xehp/Power_for_Raspberry_PI/README.md

# Power_for_Raspberry_PI
An UPS and some extras for using a Raspberry PI as web interface GUI in an embedded system.

The UPS and HAT selected need to match

RPi_HAT_isolated_rs232 and SuperCapUps10_rs232 are matching.

Copyright (C) 2021
Henrik Björkman
www.eit.se/hb
