xehp/Power_for_Raspberry_PI/openscad/raspberry_DIN_rail_box.png

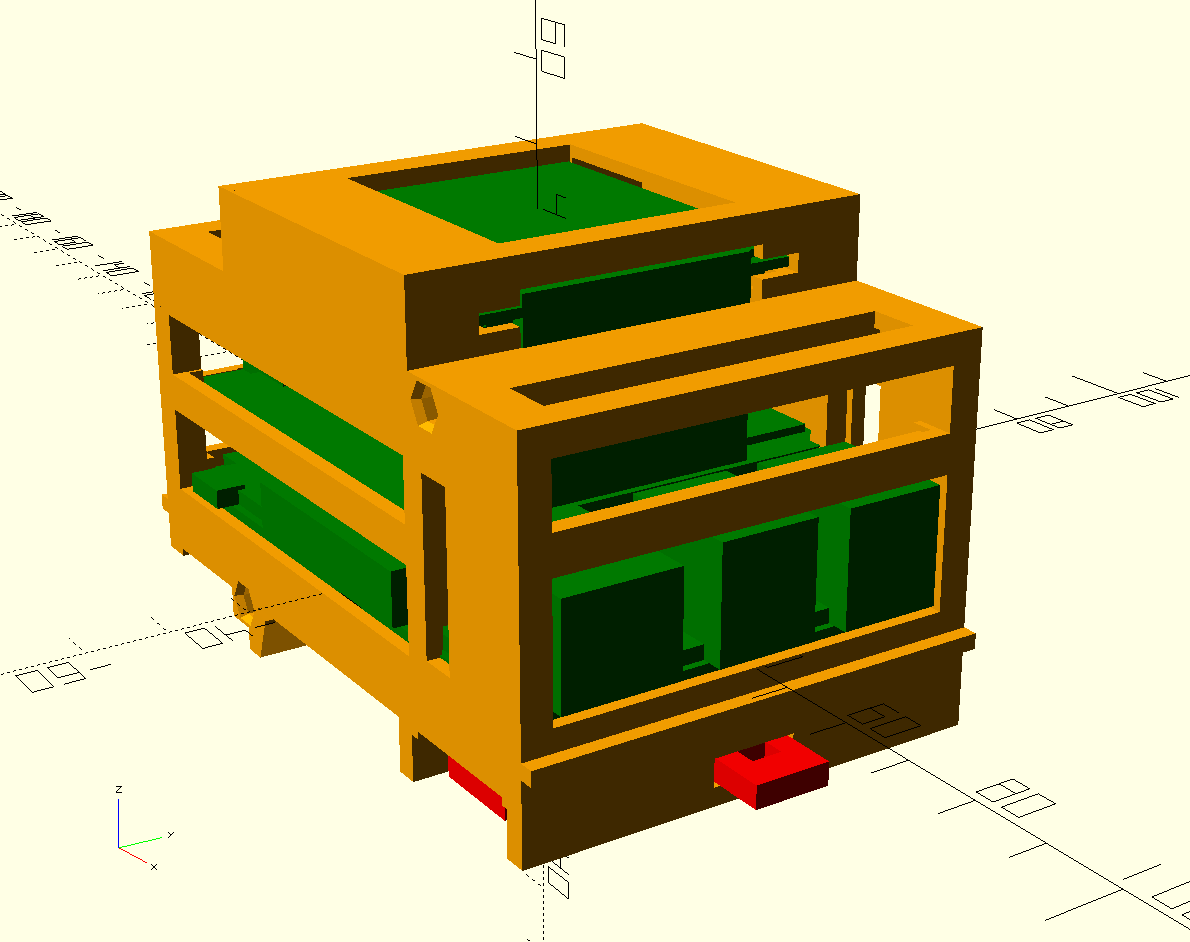
openscad/raspberry_DIN_rail_box.png
