xehp/Power_for_Raspberry_PI/habl/kicad/programmer_board/bom.txt

D41, D42
	Schottky Diode

	‎DIODE SCHOTTKY 60V 2A DO15 
	SMC Diode Solutions
	SB260TA‎
	digikey:1655-1520-1-ND‎

	For Diodes: Typically the katode (ring marked end) to the square pad. So Anode is the round pad.

D10
	Zener diode, 5.0 to 6.8 Volt.
	Littelfuse SA5.0A 	
	ESD Suppressors / TVS Diodes SA5.0A Uni-Directional
	mouser:576-SA5.0A 

	Littelfuse Inc.
	‎SA5.0A‎
	TVS DIODE 5V 9.2V DO204AC 
	digikey:SA5.0ALFCT-ND‎

D12, D20, D21, D53
	LED with builtin resistor for 5V

	Green:
	digikey:754-1891-ND

	Red:
	digikey:67-1068-ND
	
	Amber/Yellow:
	farnell:48472747

	Blue:
	Hmm, use some other color.

	For LEDs: Typically the katode (shorter leg) to square pad. So Anode (long leg) is the round pad.

D14
	Zener >=30 Volt
	TVS DIODE 33V 69.7V DO15
	STMicroelectronics (VA) / P6KE39A
	digikey:497-14733-1-ND

D60
	Diode
	digikey:1N4001-TPMSCT-ND

F70
	PTC RESET FUSE 90V 1.85A RADIAL
		digikey:507-1344-ND
	‎

J50
	micro USB
			GCT
			MICRO B SKT, BOTTOM-SMT, R/A, 30 
			‎USB3076-30-A‎
			footprint:Connector_USB:USB_Micro-B_GCT_USB3076-30-A
			digikey:2073-USB3076-30-ACT-ND‎

			Molex
			CONN RCPT USB2.0 MICRO B SMD R/A 
			‎1050170001
			footprint:Connector_USB:USB_Micro-B_Molex-105017-0001‎
			digikey:WM1399CT-ND‎

	Alternative designs:

		To be fully correct the ones above shall sit on the underside of PCB?
		This on upper side then?	
			Molex
			CONN RCPT USB2.0 MICRO B SMD R/A 
			‎1051640001‎
			digikey:WM11263CT-ND‎

	JLCPCB adapted
	
		Seems all these have same footprint (eit_footprints:USB_Micro_B_Female_jlcpcb) so any can be used.

		SHOU HAN, MicroXNJ
		footprint: USB_Micro_B_Female_jlcpcb.
		jlcpcb:C404969

		SHOU HAN, MICRO XNJ ZB
		footprint: USB_Micro_B_Female_jlcpcb.
		jlcpcb:C668587
		
		XKB Connectivity
		footprint: USB_Micro_B_Female_jlcpcb.
		jlcpcb:C319164

		Used this one (2021-06-15):

		Jing Extension of the Electronic Co.
		footprint: USB_Micro_B_Female_jlcpcb.
		jlcpcb:C10418

J60, J82
	Molex ‎0022292041‎
	CONN HEADER VERT 4POS 2.54MM 
	digikey:WM2746-ND‎

R40
	100 Ohm, >= 6 W

U10
	This one has an impressive input range:
	DC DC CONVERTER 3.3V 1.65W
	Linear Regulator Replacement DC DC Converter 1 Output 3.3V    500mA 4.75V - 36V Input
	digikey:102-4243-ND

	alternative designs:
		With 3.3 Volt Atmega can do 16MHz. But at that freq we can not get baudrate to be 115200. 
		20MHz perhaps we can but then we need 5 Volt VCC. Aha we will use 7.37 MHz.

		7805
		PMIC - spänningsregulatorer - linjära Positiv Fast 1 Utgång  1A TO-220AB
		digikey:MC7805CTGOS-ND

		heatsink
		V8508B
		digikey:A10746-ND

		Or 3.3 Volt is enough
		digikey:AP7381-33V-ADICT-ND

		Or use this one (pincompatible, will not need heatsink and gives impressive 3A):
		digikey:3182-LC78_05-3.0-ND

		DC DC CONVERTER 3.3V 2W
		digikey:945-1661-5-ND

U20
	‎ATMEGA328P-PU‎
	Microchip Technology
	IC MCU 8BIT 32KB FLASH 28DIP 
	digikey:ATMEGA328P-PU-ND‎

	Socket 28 pin DIL perhaps this:
		CONN IC DIP SOCKET 28POS GOLD 
		On Shore Technology Inc.
		‎SA283040‎
		digikey:ED3027-ND‎

	ZIF socket:
		Zero Insertion Force Socket
		28 (2 x 14) Positioner DIP, 0,3" (7,62mm) radavstånd Uttag
		digikey:1528-1926-ND

U50
	FT232RL-REEL	
	SSOP-28_5.3x10.2x0.65P
	jlcpcb:C8690

	alternatives (NOTE! not pin comatible)
	
		FTDI, Future Technology Devices International Ltd
		FT230XS-R
		IC USB SERIAL BASIC UART 16SSOP
		16-SSOP (0,154", 3,90mm bred) 
		digikey:768-1135-1-ND

		FTDI, FT230XS-R
		SSOP-16_3.9x4.9x0.635P
		jlcpcb:C69082

		FTDI, FT230XS-U
		SSOP-16_3.9x4.9x0.635P
		jlcpcb:C132162

	MORE alternatives (NOTE! not pin comatible)
		
		USB Brygga, USB till UART USB 2.0 UART Gränssnitt 16-QFN (4x4)
		digikey:768-1130-1-ND

		FT230
		Wanted "SOIC-16_W3.90mm" but are those available?

Y20
	Chrystal or resonator

	7,37MHz
		We do not need much CPU performance, this should work fine (this way we can get correct baudrate 115200):
		7,37MHz Keramisk Resonatorer Inbyggd kondensator 15pF ±0,2% 30 Ohms -20°C ~ 80°C Genomgående hål
		digikey:490-11079-ND

	16 MHz
		CERAMIC RES 16.0000MHZ 30PF T/H 
		Murata Electronics, ‎CSTLS16M0X55-B0‎
		digikey:490-1214-ND‎

		16 MHz will not give us 115200 baud.

FB50
	Inductor / Ferrite_bead
	SMD-4.2x4.4x2.0
	jlcpcb:C408335

PCB
	1) 
	Plot to gerber (at least these files):
	board-B_Cu.gbr
	board-B_Mask.gbr
	board-B_Paste.gbr
	board-B_SilkS.gbr
	board-Edge_Cuts.gbr
	board-F_Cu.gbr
	board-F_Mask.gbr
	board-F_Paste.gbr
	board-F_SilkS.gbr

	These two are not needed for 2 layer boards.
	board-In1_Cu.gbr
	board-In2_Cu.gbr

	These two perhaps not needed but I always sent them so might be required.
	board-NPTH.drl
	board-PTH.drl

	Make a zip of the above.
	
	2) 
	Go to schematic -> tools -> generate Bill Of Material "bom2grouped_csv_jlcpcb".

	3) 
	Back to layout -> fabrication outputs -> Footprint position (pos) file.
	Edit the first line in pos file. Replace as follows:
	Ref  -> Designator
	PosX -> Mid X
	PosY -> Mid Y
	Rot  -> Rotation
	Side -> Layer

	These 3 files can then be uploaded to jlcpcb.com for production.
