xehp/Power_for_Raspberry_PI/RPi_HAT_isolated_rs232/jlcpcb_2021-05-27/downloaded_bom.xls

Comment | Designator | Package | LCSC Part
10 uF | C21,C22,C23,C28 | Capacitor_SMD:C_1206_3216Metric | C13585
3.9K | R6,R8 | Resistor_SMD:R_0805_2012Metric_Pad1.15x1.40mm_HandSolder | C17614
D | D1 | Diode_SMD:D_SOD-123 | C8598
D | D21 | Diode_SMD:D_SMC | C35722
100 | R32 | Resistor_SMD:R_0805_2012Metric_Pad1.15x1.40mm_HandSolder | C17408
0.01 uF | C32 | Capacitor_SMD:C_0805_2012Metric_Pad1.15x1.40mm_HandSolder | C1710
0.1uF | C1,C2,C29,C31 | Capacitor_SMD:C_0805_2012Metric_Pad1.15x1.40mm_HandSolder | C49678
330 | R22,R26,R28 | Resistor_SMD:R_0805_2012Metric | C17630
10K | R29 | Resistor_SMD:R_0805_2012Metric | C17414
D_Zener | D26 | Diode_SMD:D_SMB | C78395
1k | R1,R31,R27 | Resistor_SMD:R_0805_2012Metric_Pad1.15x1.40mm_HandSolder | C17513
1K | R1,R31,R27 | Resistor_SMD:R_0805_2012Metric_Pad1.15x1.40mm_HandSolder | C17513
22 uF | C24,C25,C26,C27 | Capacitor_SMD:C_0805_2012Metric | C45783
100k | R25 | Resistor_SMD:R_0805_2012Metric_Pad1.15x1.40mm_HandSolder | C17407
