xehp/Power_for_Raspberry_PI/RPi_HAT_isolated_rs232/jlcpcb_2021-06-15/bom.xls

Comment | Designator | Package | LCSC Part
0805W8F2201T5E | R31,R39 | Resistor_SMD:R_0805_2012Metric_Pad1.15x1.40mm_HandSolder | C17520
CL31A106KBHNNNE | C21,C22,C23,C28,C70,C71 | Capacitor_SMD:C_1206_3216Metric | C13585
MAX232ESE+T | U60 | Package_SO:SOIC-16_3.9x9.9mm_P1.27mm | C26860
M24C02-WMN6TP | U2 | Housings_SOIC:SOIC-8_3.9x4.9mm_Pitch1.27mm | C7562
0805W8F2200T5E | R3 | Resistor_SMD:R_0805_2012Metric_Pad1.15x1.40mm_HandSolder | C17557
CL21B103KBANNNC | C32,C3,C20 | Capacitor_SMD:C_0805_2012Metric | C1710
CL21B103KBANNNC | C32,C3,C20 | Capacitor_SMD:C_0805_2012Metric | C1710
0805W8F3901T5E | R6,R8 | Resistor_SMD:R_0805_2012Metric_Pad1.15x1.40mm_HandSolder | C17614
CC0805KRX7R9BB104 | C29,C1,C2,C31,C60,C61,C62,C63,C64,C24 | Capacitor_SMD:C_0805_2012Metric | C49678
0805W8F3300T5E | R1 | Resistor_SMD:R_0805_2012Metric_Pad1.15x1.40mm_HandSolder | C17630
0805W8F1002T5E | R29 | Resistor_SMD:R_0805_2012Metric | C17414
1206W4F2200T5E | R20 | Resistor_SMD:R_1206_3216Metric | C17957
P6SMB6.8CA | D26 | Diode_SMD:D_SMB | C78395
CL31A476MPHNNNE | C25,C26,C27 | Capacitor_SMD:C_1206_3216Metric | C96123
SS54 | D21 | Diode_SMD:D_SMA | C22452
0805W8F3301T5E | R2 | Resistor_SMD:R_0805_2012Metric_Pad1.15x1.40mm_HandSolder | C26010
0805W8F1001T5E | R27,R28 | Resistor_SMD:R_0805_2012Metric | C17513
0805W8F1500T5E | R26,R32,R38 | Resistor_SMD:R_0805_2012Metric | C17471
MMBT5401 | Q1,Q39 | Package_TO_SOT_SMD:SOT-23 | C8326
NCD0805R1 | D1,D24,D39 | LED_SMD:LED_0805_2012Metric | C84256
