xehp/Power_for_Raspberry_PI/RPi_HAT_isolated_rs232/jlcpcb_2021-05-27/schematics_2021-05-27.pdf

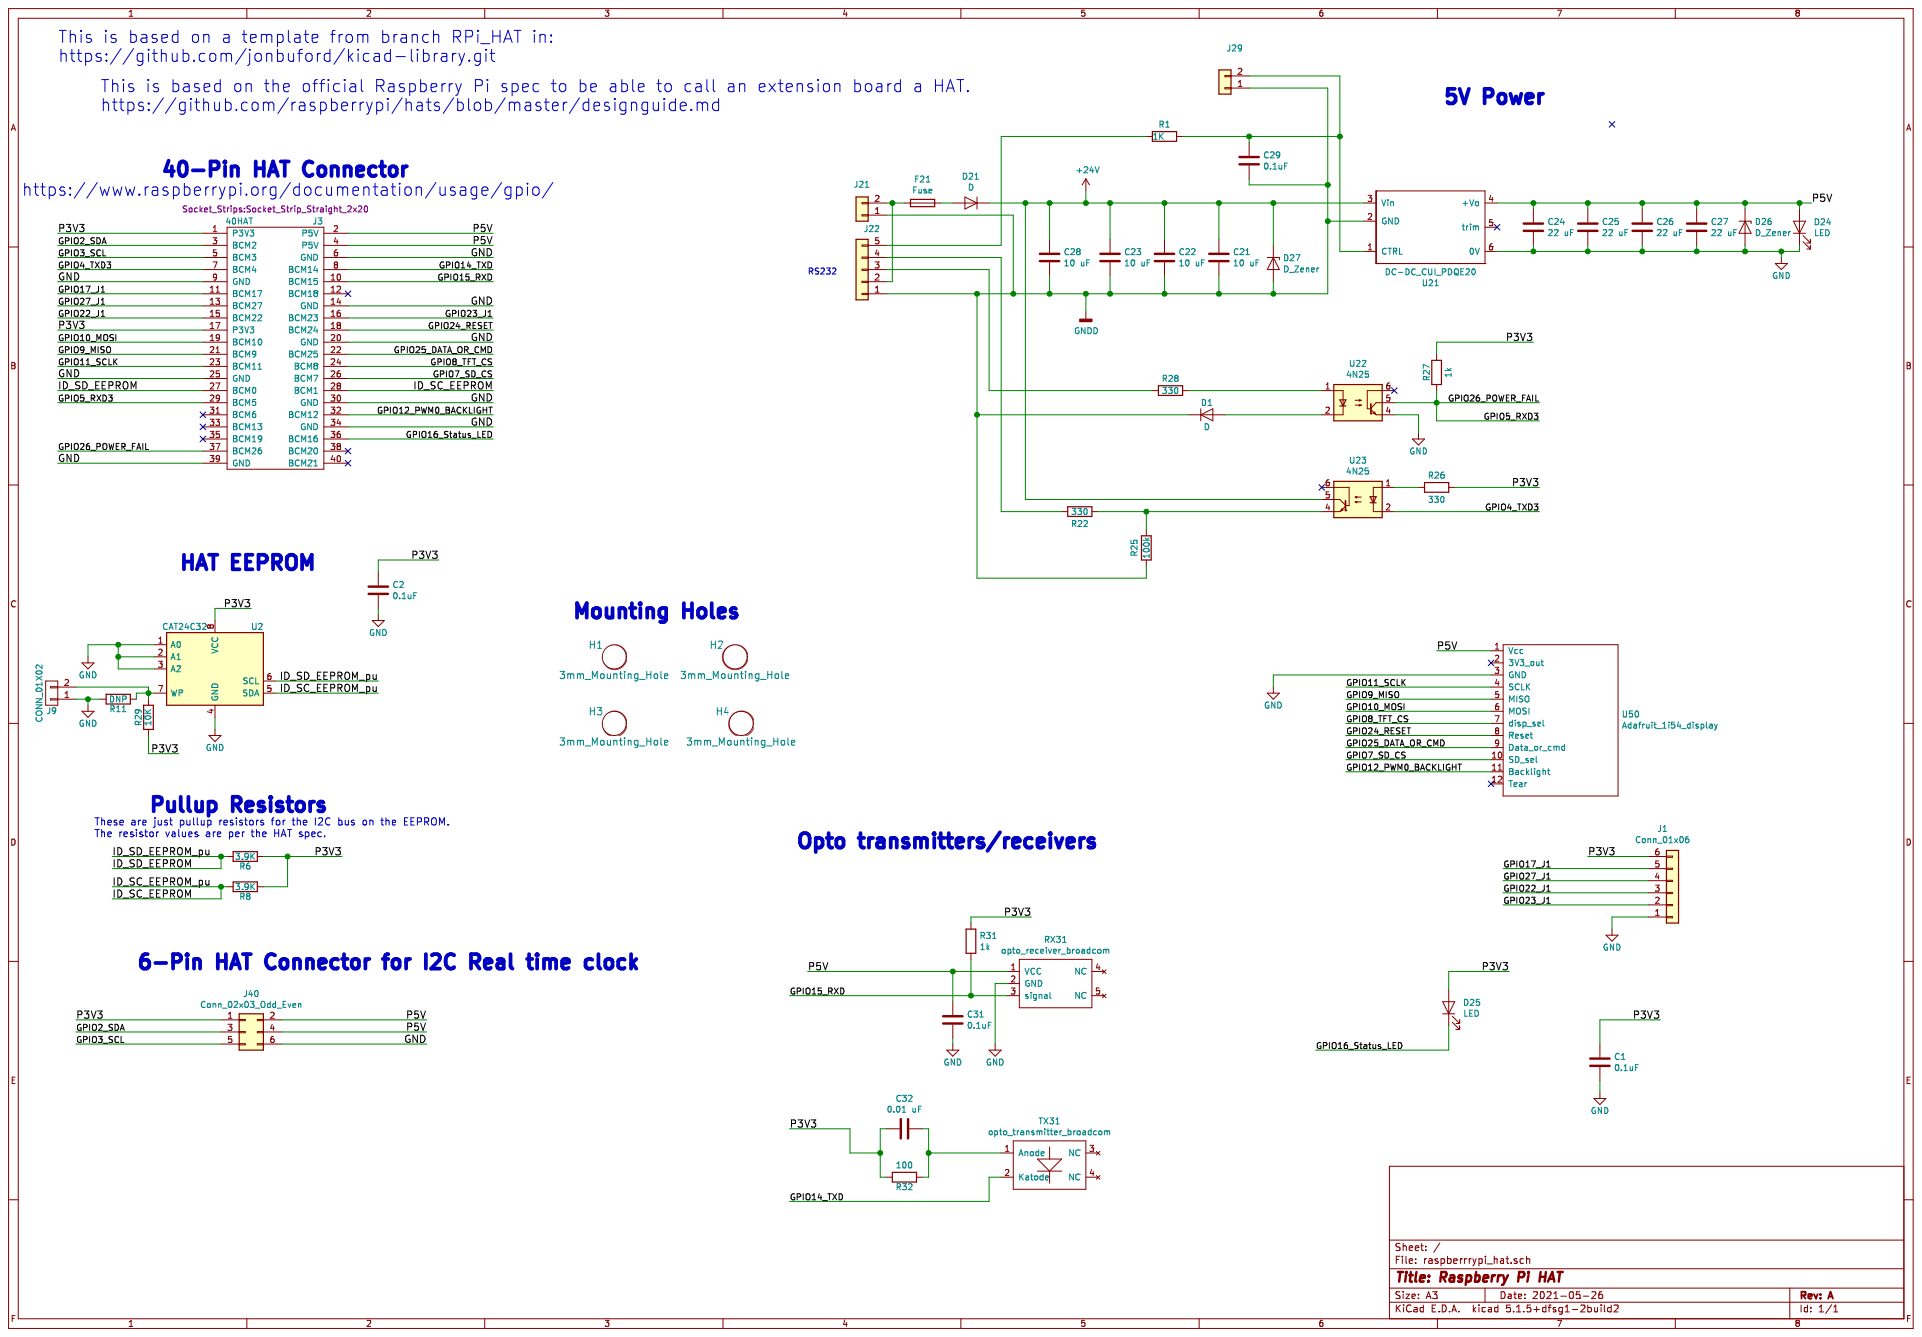
[picture p2: page 1]
