xehp/Power_for_Raspberry_PI/RPi_HAT_isolated_rs232/jlcpcb_2021-06-15/schematics.pdf

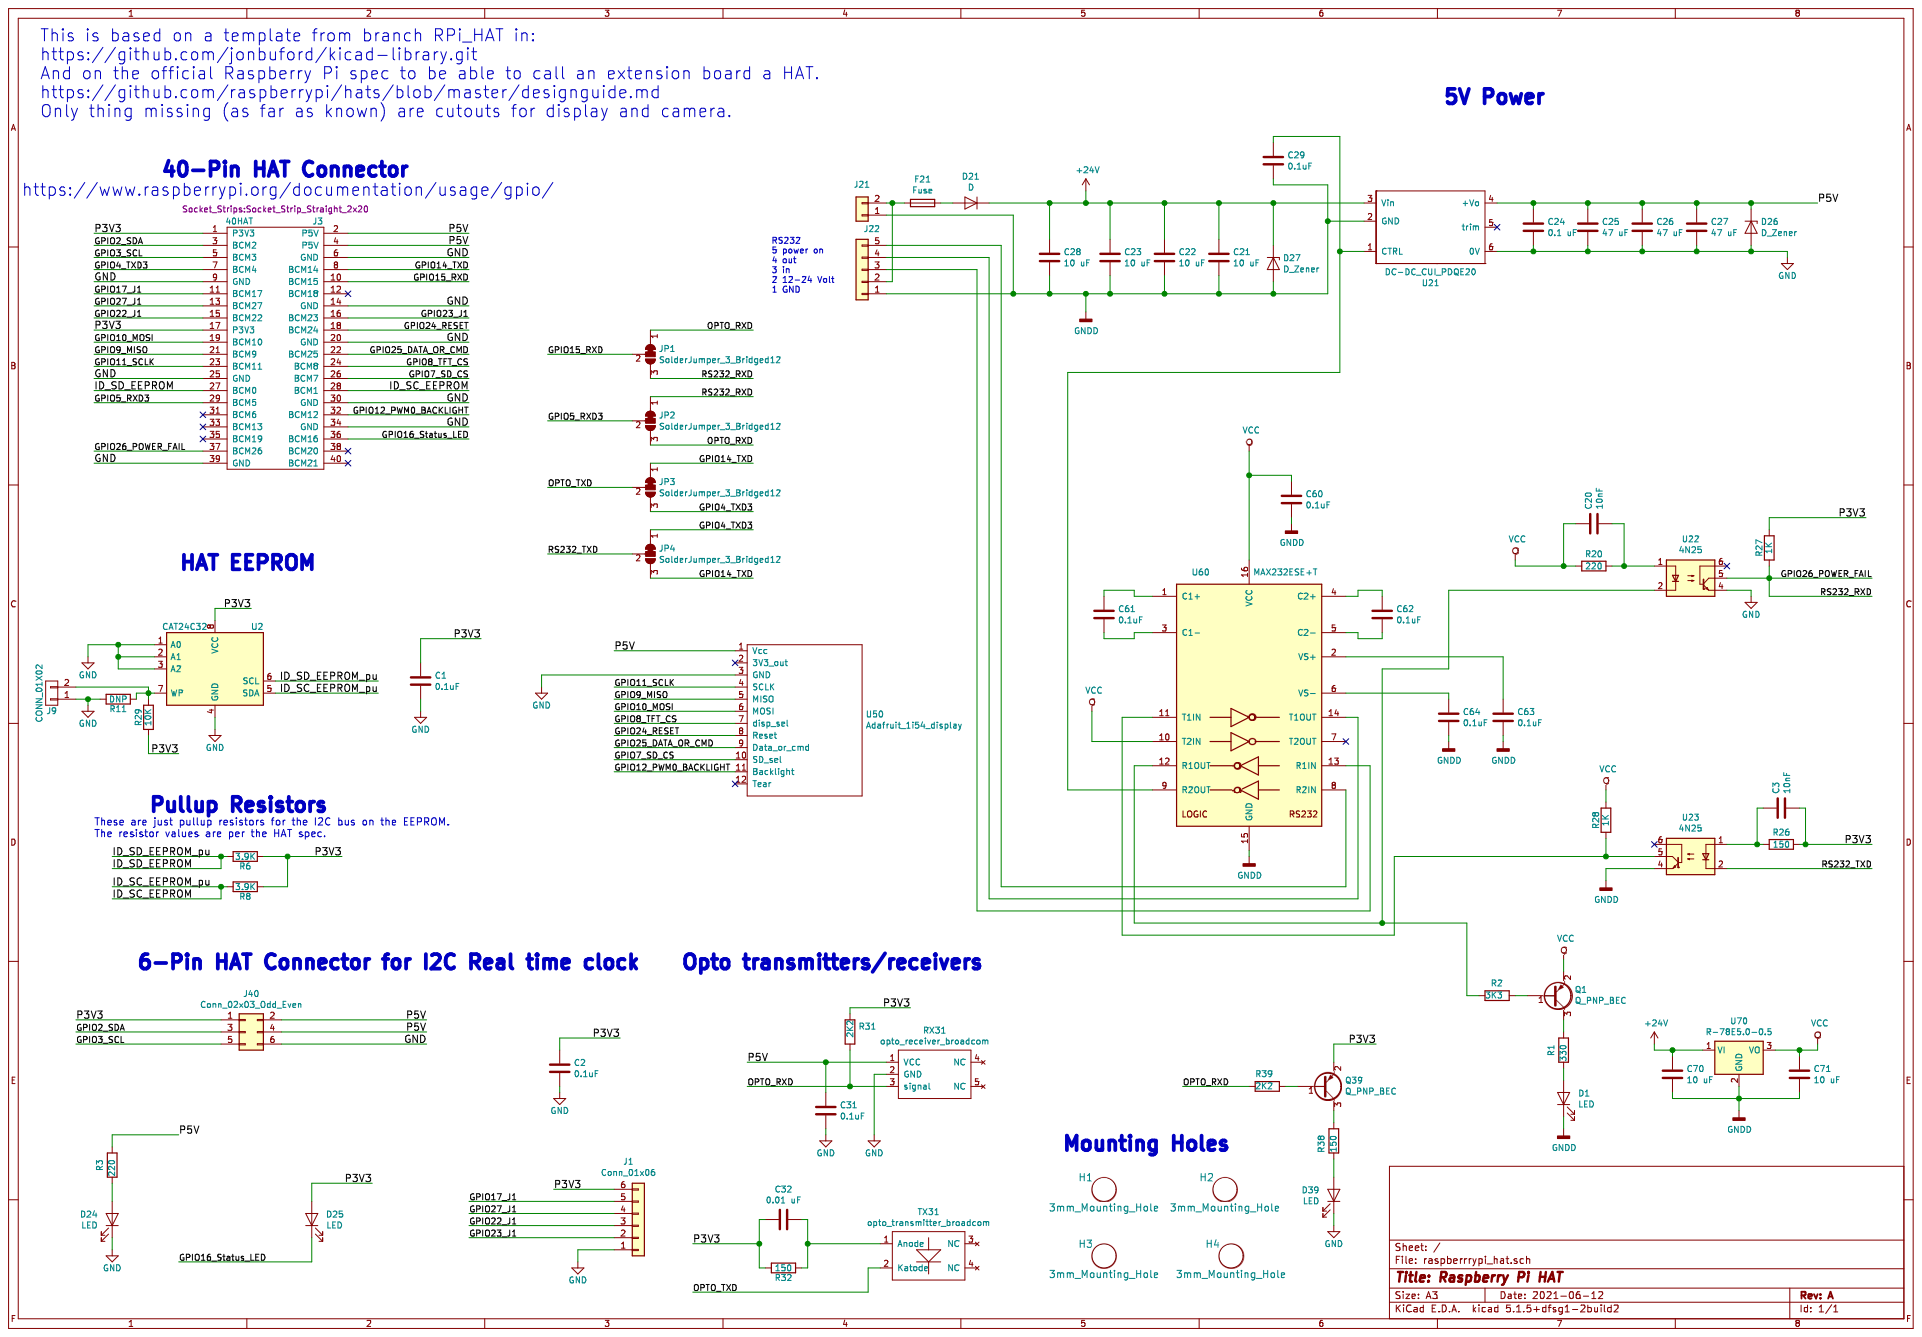
[picture p3: page 1]
