xehp/Power_for_Raspberry_PI/SuperCapUps7_rs232/jlcpcb_2021-06-14/schematics.pdf

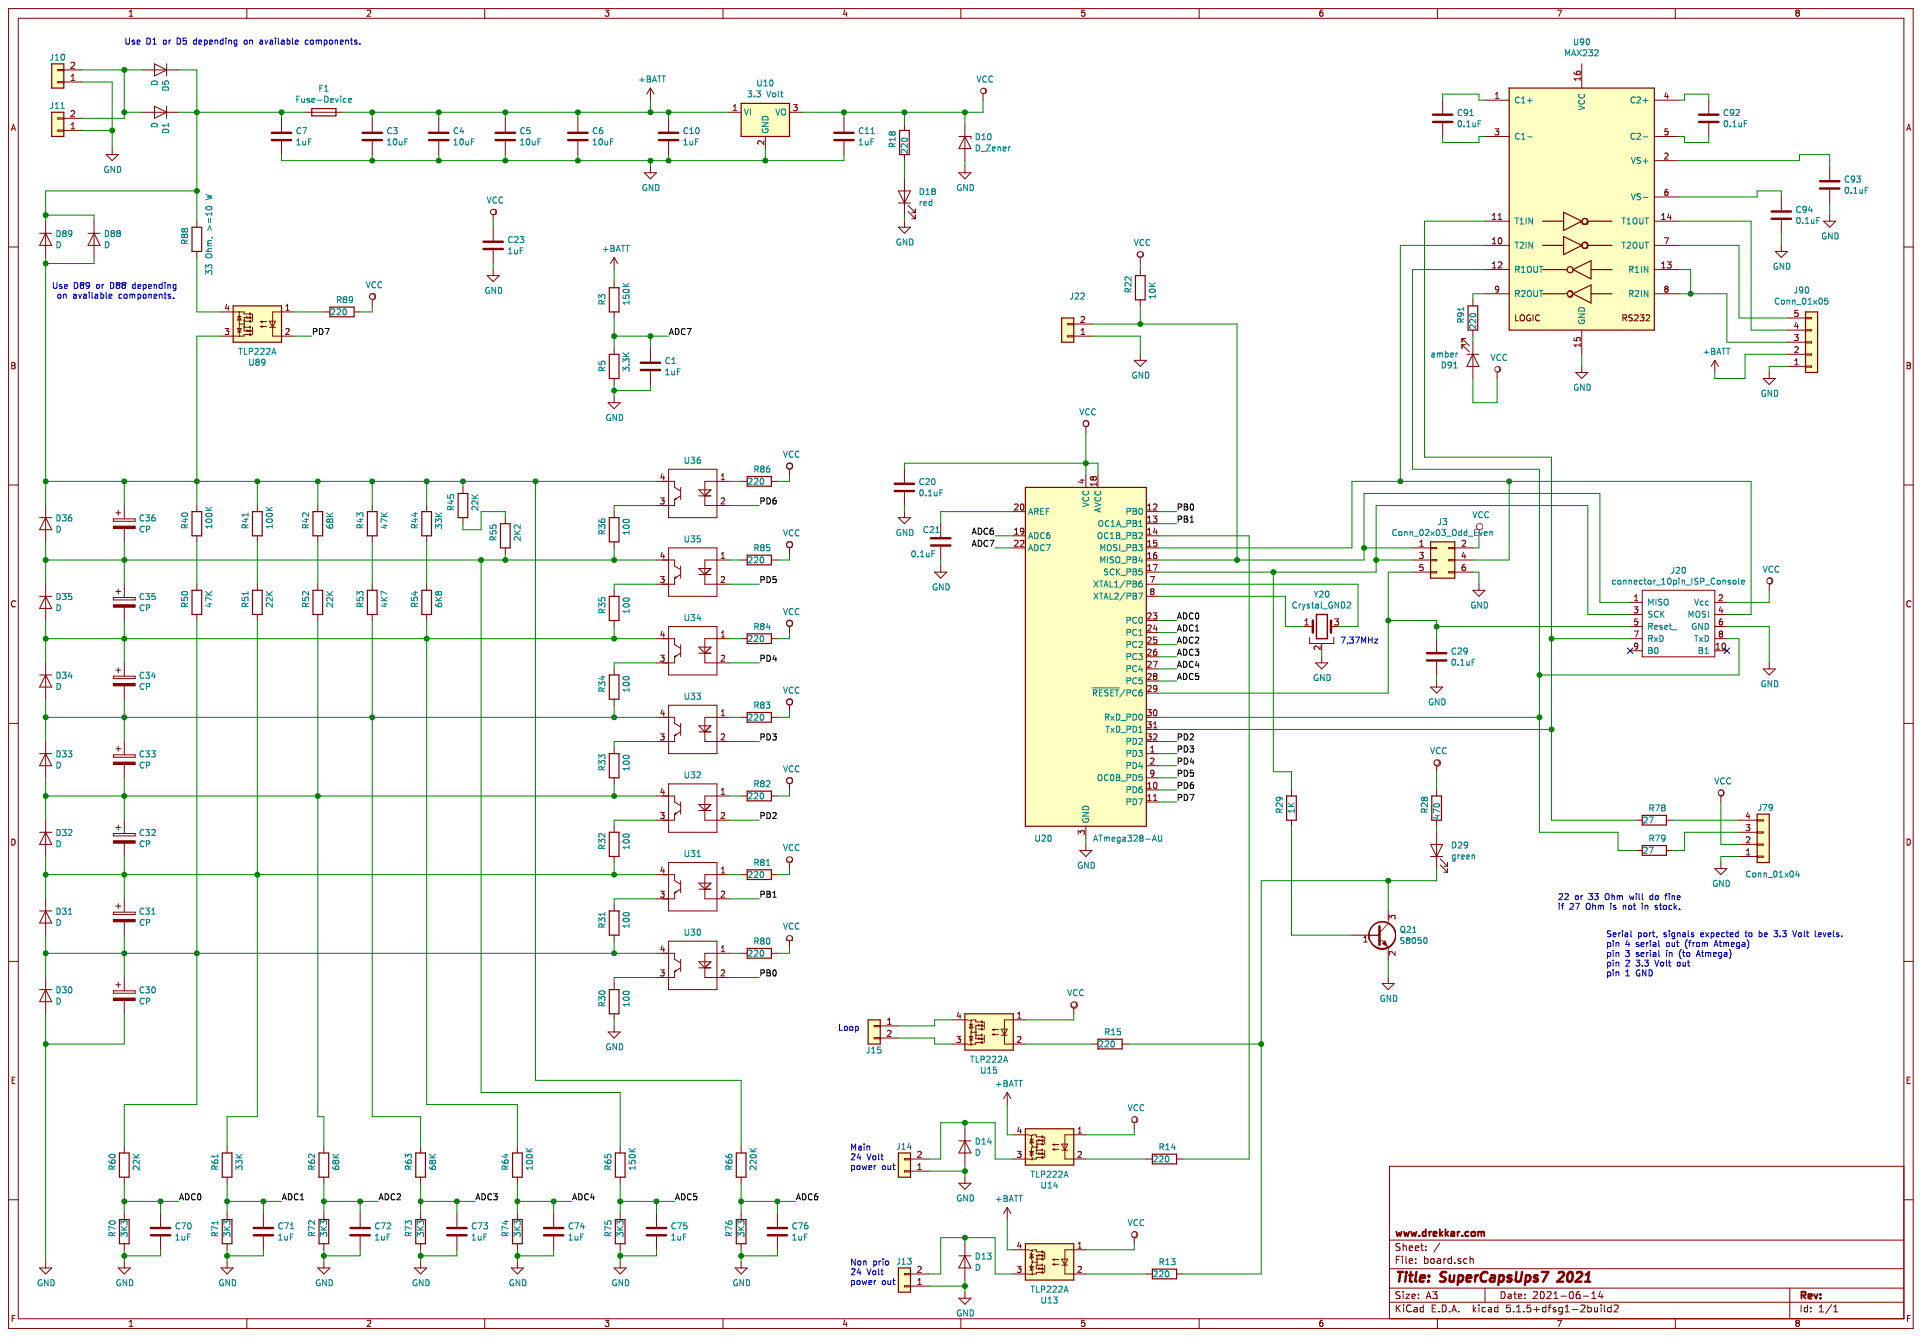
[picture p4: page 1]
