xehp/Power_for_Raspberry_PI/RPi_HAT_isolated_rs232/raspberrrypi_hat.kicad_pcb

## KiCad design RPi_HAT_isolated_rs232/raspberrrypi_hat.kicad_pcb (2021-10-06)

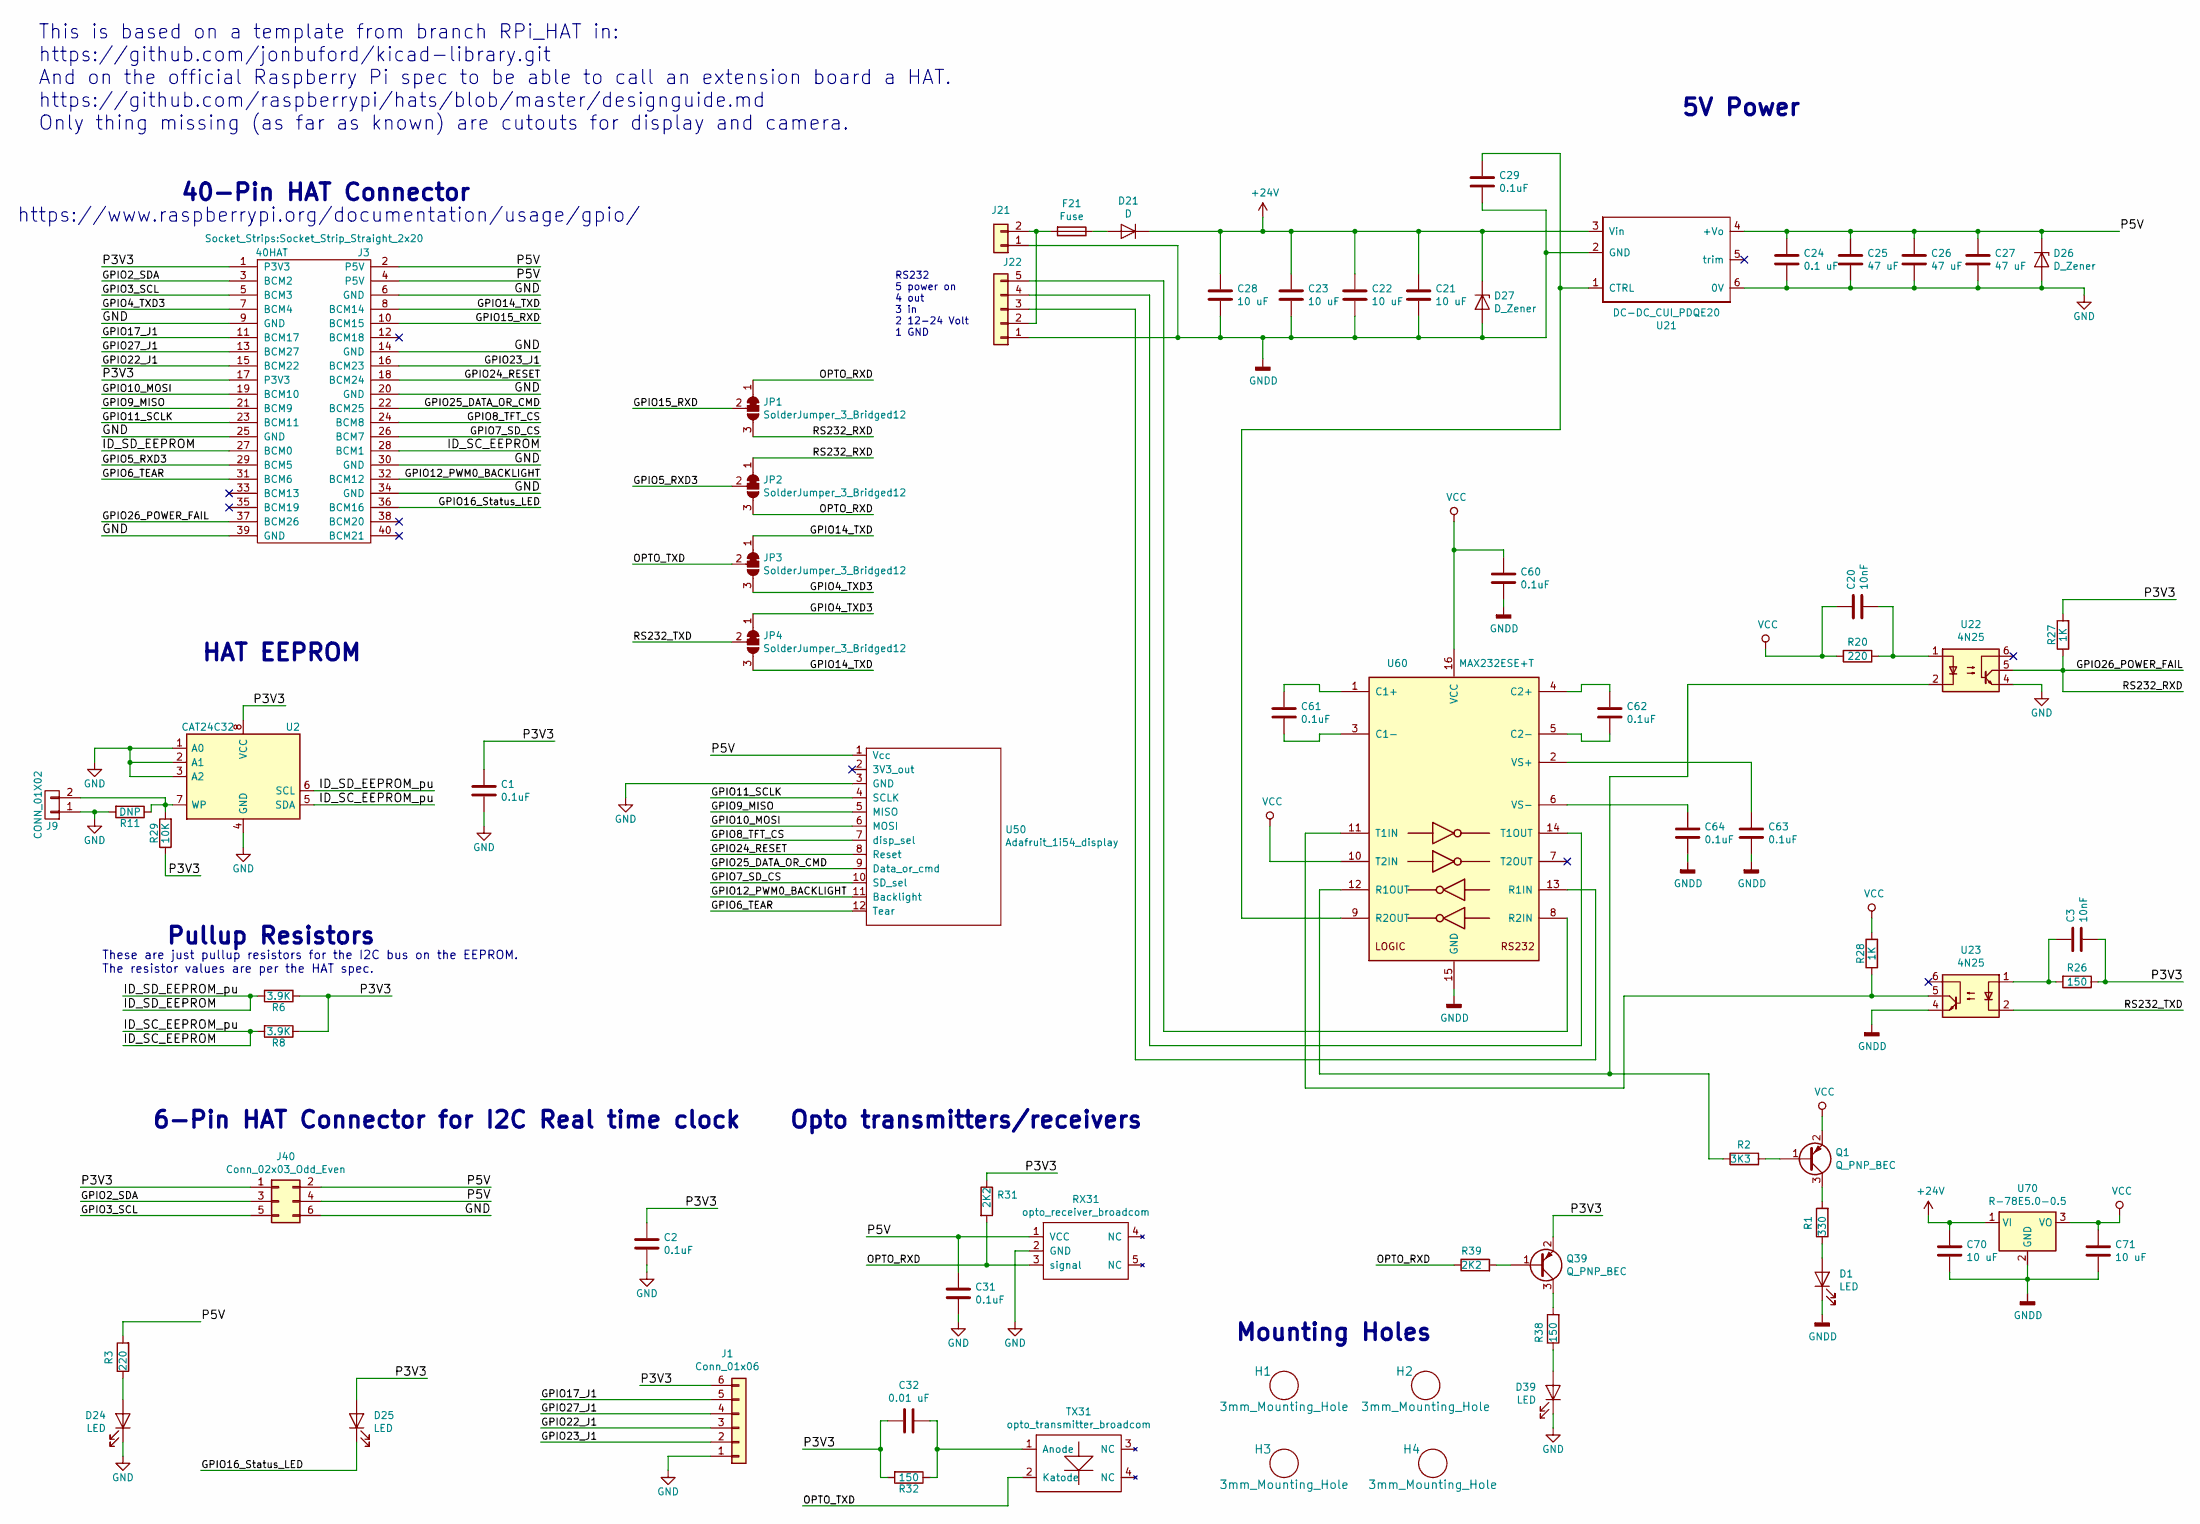
[picture p5: schematic raspberrrypi_hat.sch, Raspberry Pi HAT]

Parts:
C1, C2, C31, C60, C61, C62, C63, C64: 0.1uF; C_0805_2012Metric
C3, C20: 10nF; C_0805_2012Metric
C21, C22, C23, C28, C70, C71: 10 uF; C_1206_3216Metric
C24: 0.1 uF; C_0805_2012Metric
C25, C26, C27: 47 uF; C_1206_3216Metric
C29: 0.1uF; C_0805_2012Metric_Pad1.15x1.40mm_HandSolder
C32: 0.01 uF; C_0805_2012Metric
D1, D24, D39: LED; LED_0805_2012Metric
D21: D; D_SMA
D25: LED; LED_D3.0mm
D26: D_Zener; D_SMB
D27: D_Zener; D_A-405_P2.54mm_Vertical_AnodeUp
F21: Fuse; R_Radial_Power_L11.0mm_W7.0mm_P5.00mm
H1, H2, H3, H4: 3mm_Mounting_Hole; NPTH_3mm_ID
J1: Conn_01x06; Molex_KK-254_AE-6410-06A_1x06_P2.54mm_Vertical
J3: 40HAT; Socket_Strip_Straight_2x20
J9: CONN_01X02; PinHeader_1x02_P2.54mm_Vertical
J21: Conn_01x02; connector_TE_Connectivity_2_pin
J22: Conn_01x05; Molex_KK-254_AE-6410-05A_1x05_P2.54mm_Vertical
J40: Conn_02x03_Odd_Even; PinHeader_2x03_P2.54mm_Vertical
JP1, JP2, JP3, JP4: SolderJumper_3_Bridged12; SolderJumper-3_P2.0mm_Open_TrianglePad1.0x1.5mm_NumberLabels
Q1, Q39: Q_PNP_BEC; SOT-23
R1: 330; R_0805_2012Metric_Pad1.15x1.40mm_HandSolder
R2: 3K3; R_0805_2012Metric_Pad1.15x1.40mm_HandSolder
R3: 220; R_0805_2012Metric_Pad1.15x1.40mm_HandSolder
R6, R8: 3.9K; R_0805_2012Metric_Pad1.15x1.40mm_HandSolder; MPN RC0402JR-0722RL
R11: DNP; R_0805_HandSoldering; MPN RC0402JR-0722RL
R20: 220; R_1206_3216Metric; MPN RC0402JR-0722RL
R26: 150; R_0805_2012Metric; MPN RC0402JR-0722RL
R27, R28: 1K; R_0805_2012Metric; MPN RC0402JR-0722RL
R29: 10K; R_0805_2012Metric; MPN RC0402JR-0722RL
R31, R39: 2K2; R_0805_2012Metric_Pad1.15x1.40mm_HandSolder
R32: 150; R_0805_2012Metric_Pad1.15x1.40mm_HandSolder; MPN RC0402JR-0722RL
R38: 150; R_0805_2012Metric_Pad1.15x1.40mm_HandSolder
RX31: opto_receiver_broadcom; opto_receiver_broadwell
TX31: opto_transmitter_broadcom; opto_transmitter_broadwell
U2: CAT24C32; SOIC-8_3.9x4.9mm_Pitch1.27mm
U21: DC-DC_CUI_PDQE20; DC-DC_CUI_PDQE20-D
U22, U23: 4N25; DIP-6_W7.62mm
U50: Adafruit_1i54_display
U60: MAX232ESE+T; SOIC-16_3.9x9.9mm_P1.27mm
U70: R-78E5.0-0.5; DC-DC-Recom-R78

Connections:
+24V: C21.1, C22.1, C23.1, C28.1, C70.1, D21.1 (K), D27.1 (K), U21.3 (Vin), U70.1 (VI)
/GPIO2_SDA: J3.3 (BCM2), J40.3
/GPIO3_SCL: J3.5 (BCM3), J40.5
/GPIO4_TXD3: J3.7 (BCM4), JP3.3 (B), JP4.1 (A)
/GPIO5_RXD3: J3.29 (BCM5), JP2.2 (C)
/GPIO7_SD_CS: J3.26 (BCM7), U50.10 (SD_sel)
/GPIO8_TFT_CS: J3.24 (BCM8), U50.7 (disp_sel)
/GPIO9_MISO: J3.21 (BCM9), U50.5 (MISO)
/GPIO10_MOSI: J3.19 (BCM10), U50.6 (MOSI)
/GPIO11_SCLK: J3.23 (BCM11), U50.4 (SCLK)
/GPIO12_PWM0_BACKLIGHT: J3.32 (BCM12), U50.11 (Backlight)
/GPIO14_TXD: J3.8 (BCM14), JP3.1 (A), JP4.3 (B)
/GPIO15_RXD: J3.10 (BCM15), JP1.2 (C)
/GPIO16_Status_LED: D25.1 (K), J3.36 (BCM16)
/GPIO17_J1: J1.5, J3.11 (BCM17)
/GPIO22_J1: J1.3, J3.15 (BCM22)
/GPIO23_J1: J1.2, J3.16 (BCM23)
/GPIO24_RESET: J3.18 (BCM24), U50.8 (Reset)
/GPIO25_DATA_OR_CMD: J3.22 (BCM25), U50.9 (Data_or_cmd)
/GPIO26_POWER_FAIL: J3.37 (BCM26), JP1.3 (B), JP2.1 (A), R27.1, U22.5
/GPIO27_J1: J1.4, J3.13 (BCM27)
/ID_SC_EEPROM: J3.28 (BCM1), R8.2, U2.5 (SDA)
/ID_SD_EEPROM: J3.27 (BCM0), R6.2, U2.6 (SCL)
/OPTO_RXD: JP1.1 (A), JP2.3 (B), R31.2, R39.1, RX31.3 (signal)
/OPTO_TXD: JP3.2 (C), TX31.2 (Katode)
/P3V3: C1.1, C2.1, C3.2, C32.2, D25.2 (A), J1.6, J3.1 (P3V3), J3.17 (P3V3), J40.1, Q39.2 (E), R6.1, R8.1, R26.1, R27.2, R29.1, R31.1, R32.2, U2.8 (VCC)
/P5V: C24.1, C25.1, C26.1, C27.1, C31.1, D26.1 (K), J3.2 (P5V), J3.4 (P5V), J40.2, J40.4, R3.2, RX31.1 (VCC), U21.4 (+Vo), U50.1 (Vcc)
/RS232_TXD: JP4.2 (C), U23.2
GND: C1.2, C2.2, C24.2, C25.2, C26.2, C27.2, C31.2, D24.1 (K), D26.2 (A), D39.1 (K), J1.1, J3.6 (GND), J3.9 (GND), J3.14 (GND), J3.20 (GND), J3.25 (GND), J3.30 (GND), J3.34 (GND), J3.39 (GND), J9.1, J40.6, R11.2, RX31.2 (GND), U2.1 (A0), U2.2 (A1), U2.3 (A2), U2.4 (GND), U21.6 (0V), U22.4, U50.3 (GND)
GNDD: C21.2, C22.2, C23.2, C28.2, C29.2, C60.2, C63.2, C64.2, C70.2, C71.2, D1.1 (K), D27.2 (A), J21.1, J22.1, U21.2 (GND), U23.4, U60.15 (GND), U70.2 (GND)
unnamed: C3.1, R26.2, U23.1
unnamed: C20.2, R20.1, U22.1
unnamed: C29.1, U21.1 (CTRL), U60.9 (R2OUT)
unnamed: C32.1, R32.1, TX31.1 (Anode)
unnamed: C61.1, U60.1 (C1+)
unnamed: C61.2, U60.3 (C1-)
unnamed: C62.1, U60.4 (C2+)
unnamed: C62.2, U60.5 (C2-)
unnamed: C63.1, U60.2 (VS+)
unnamed: C64.1, U60.6 (VS-)
unnamed: D1.2 (A), R1.1
unnamed: D21.2 (A), F21.1
unnamed: D24.2 (A), R3.1
unnamed: D39.2 (A), R38.1
unnamed: F21.2, J21.2, J22.2
unnamed: J9.2, R11.1, R29.2, U2.7 (WP)
unnamed: J22.3, U60.13 (R1IN)
unnamed: J22.4, U60.14 (T1OUT)
unnamed: J22.5, U60.8 (R2IN)
unnamed: Q1.1 (B), R2.2
unnamed: Q1.3 (C), R1.2
unnamed: Q39.1 (B), R39.2
unnamed: Q39.3 (C), R38.2
unnamed: R2.1, U22.2, U60.12 (R1OUT)
unnamed: R28.1, U23.5, U60.11 (T1IN)
VCC: C20.1, C60.1, C71.1, Q1.2 (E), R20.2, R28.2, U60.10 (T2IN), U60.16 (VCC), U70.3 (VO)

Notes on the sheet:
Pullup Resistors
HAT EEPROM
Mounting Holes
40-Pin HAT Connector
These are just pullup resistors for the I2C bus on the EEPROM. The resistor values are per the HAT spec.
This is based on a template from branch RPi_HAT in: https://github.com/jonbuford/kicad-library.git And on the official Raspberry Pi spec to be able to call an extension board a HAT. https://github.com/raspberrypi/hats/blob/master/designguide.md Only thing missing (as far as known) are cutouts for d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
Opto transmitters/receivers
6-Pin HAT Connector for I2C Real time clock
https://www.raspberrypi.org/documentation/usage/gpio/
5V Power
RS232 5 power on 4 out 3 in 2 12-24 Volt 1 GND

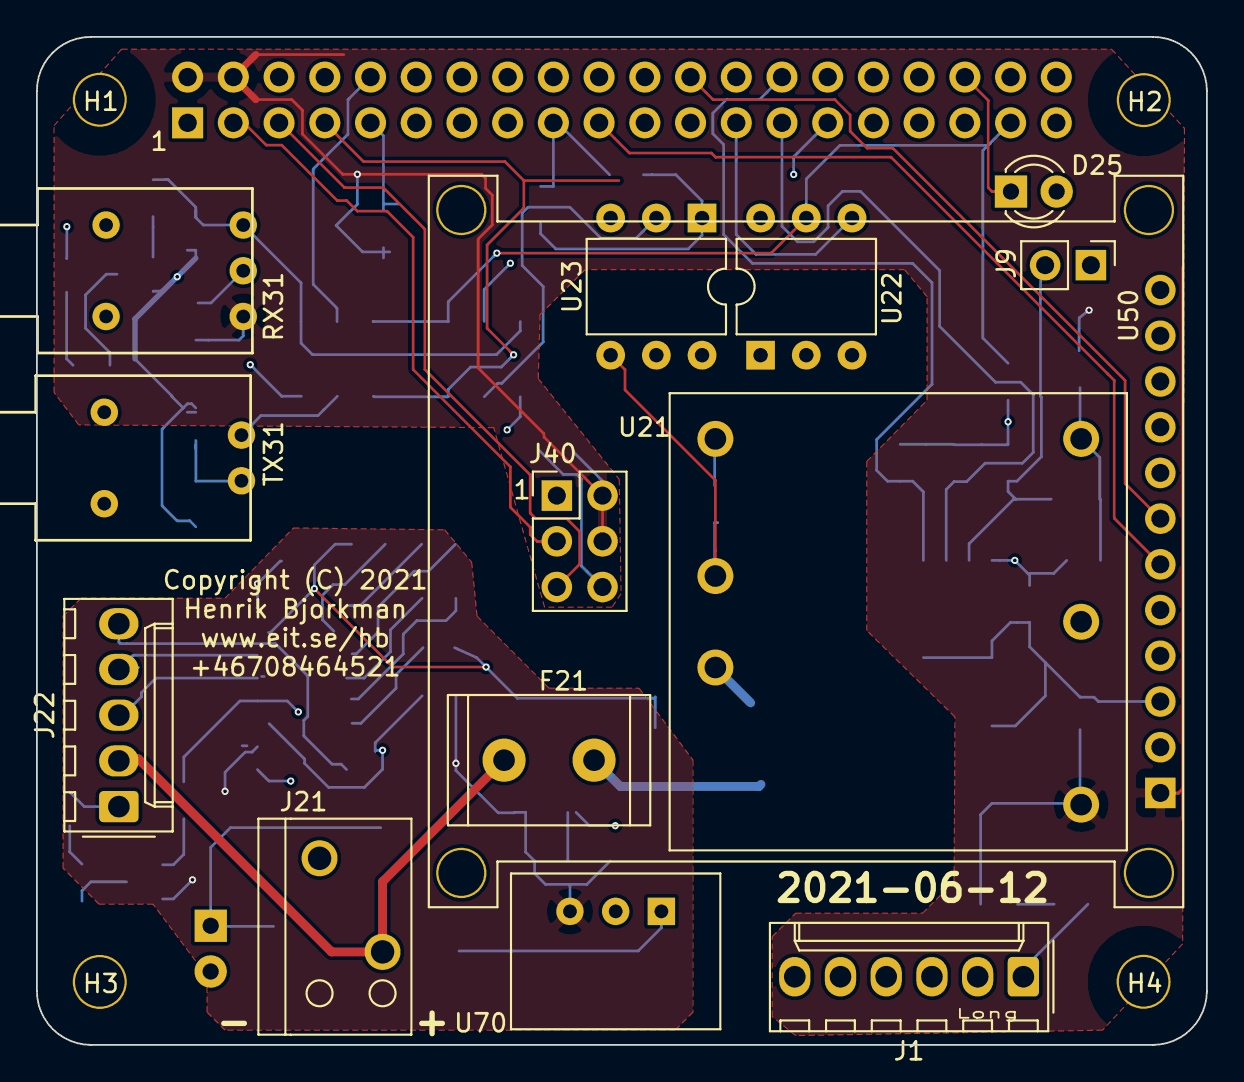
[picture p6: board raspberrrypi_hat.kicad_pcb from above]

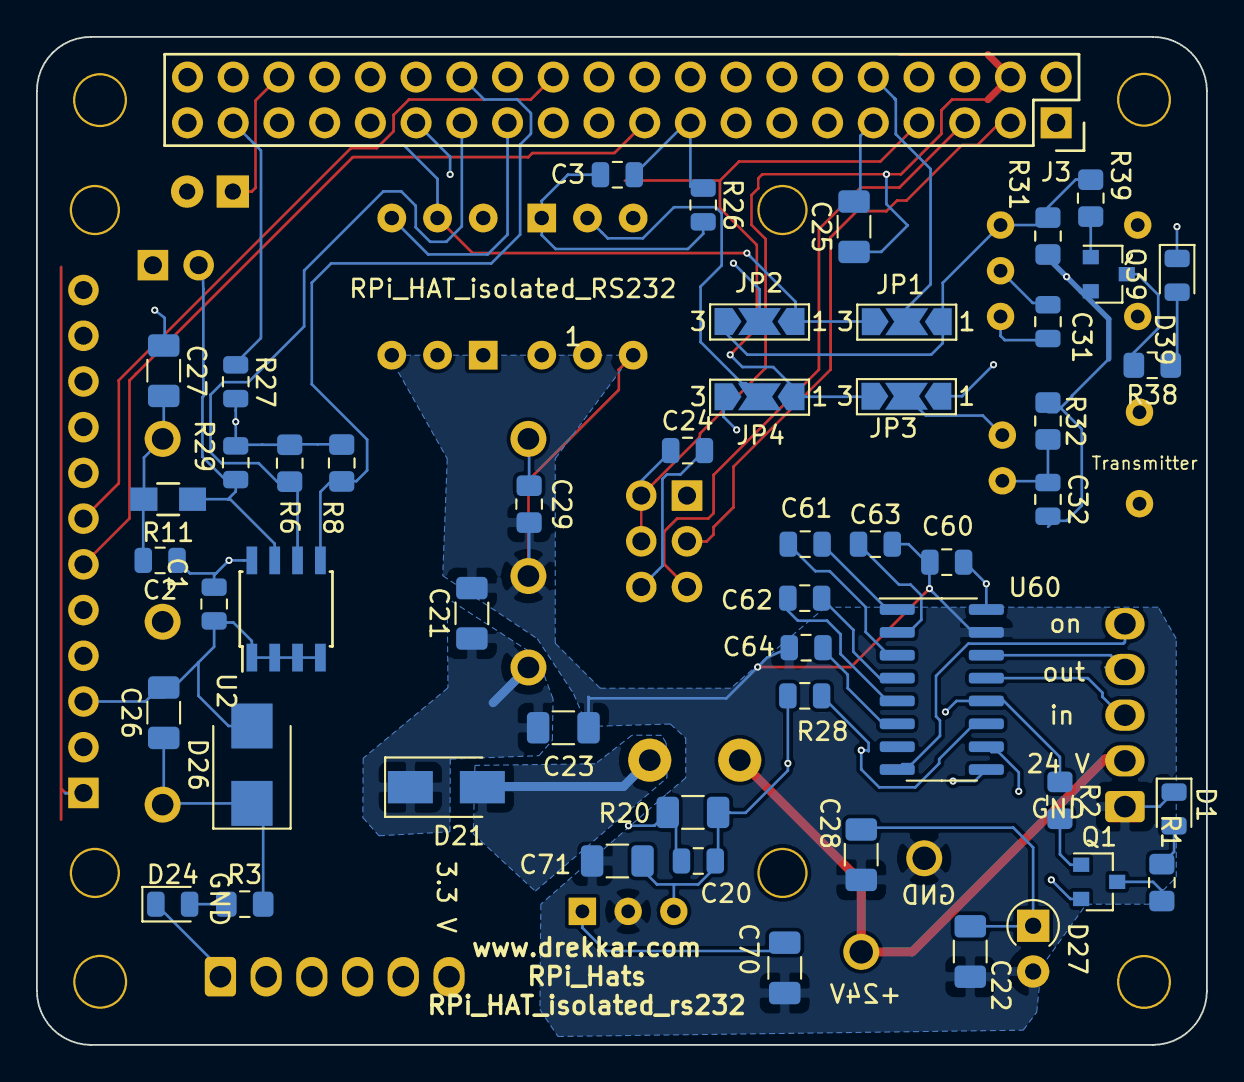
[picture p7: board raspberrrypi_hat.kicad_pcb from below]

Board: 4 copper layers, 65.0 x 56.0 mm, 70 parts (52 on the bottom side), 56 nets.
