xehp/Power_for_Raspberry_PI/SuperCapUps7_rs232/board.kicad_pcb

## KiCad design SuperCapUps7_rs232/board.kicad_pcb (2021-09-27)

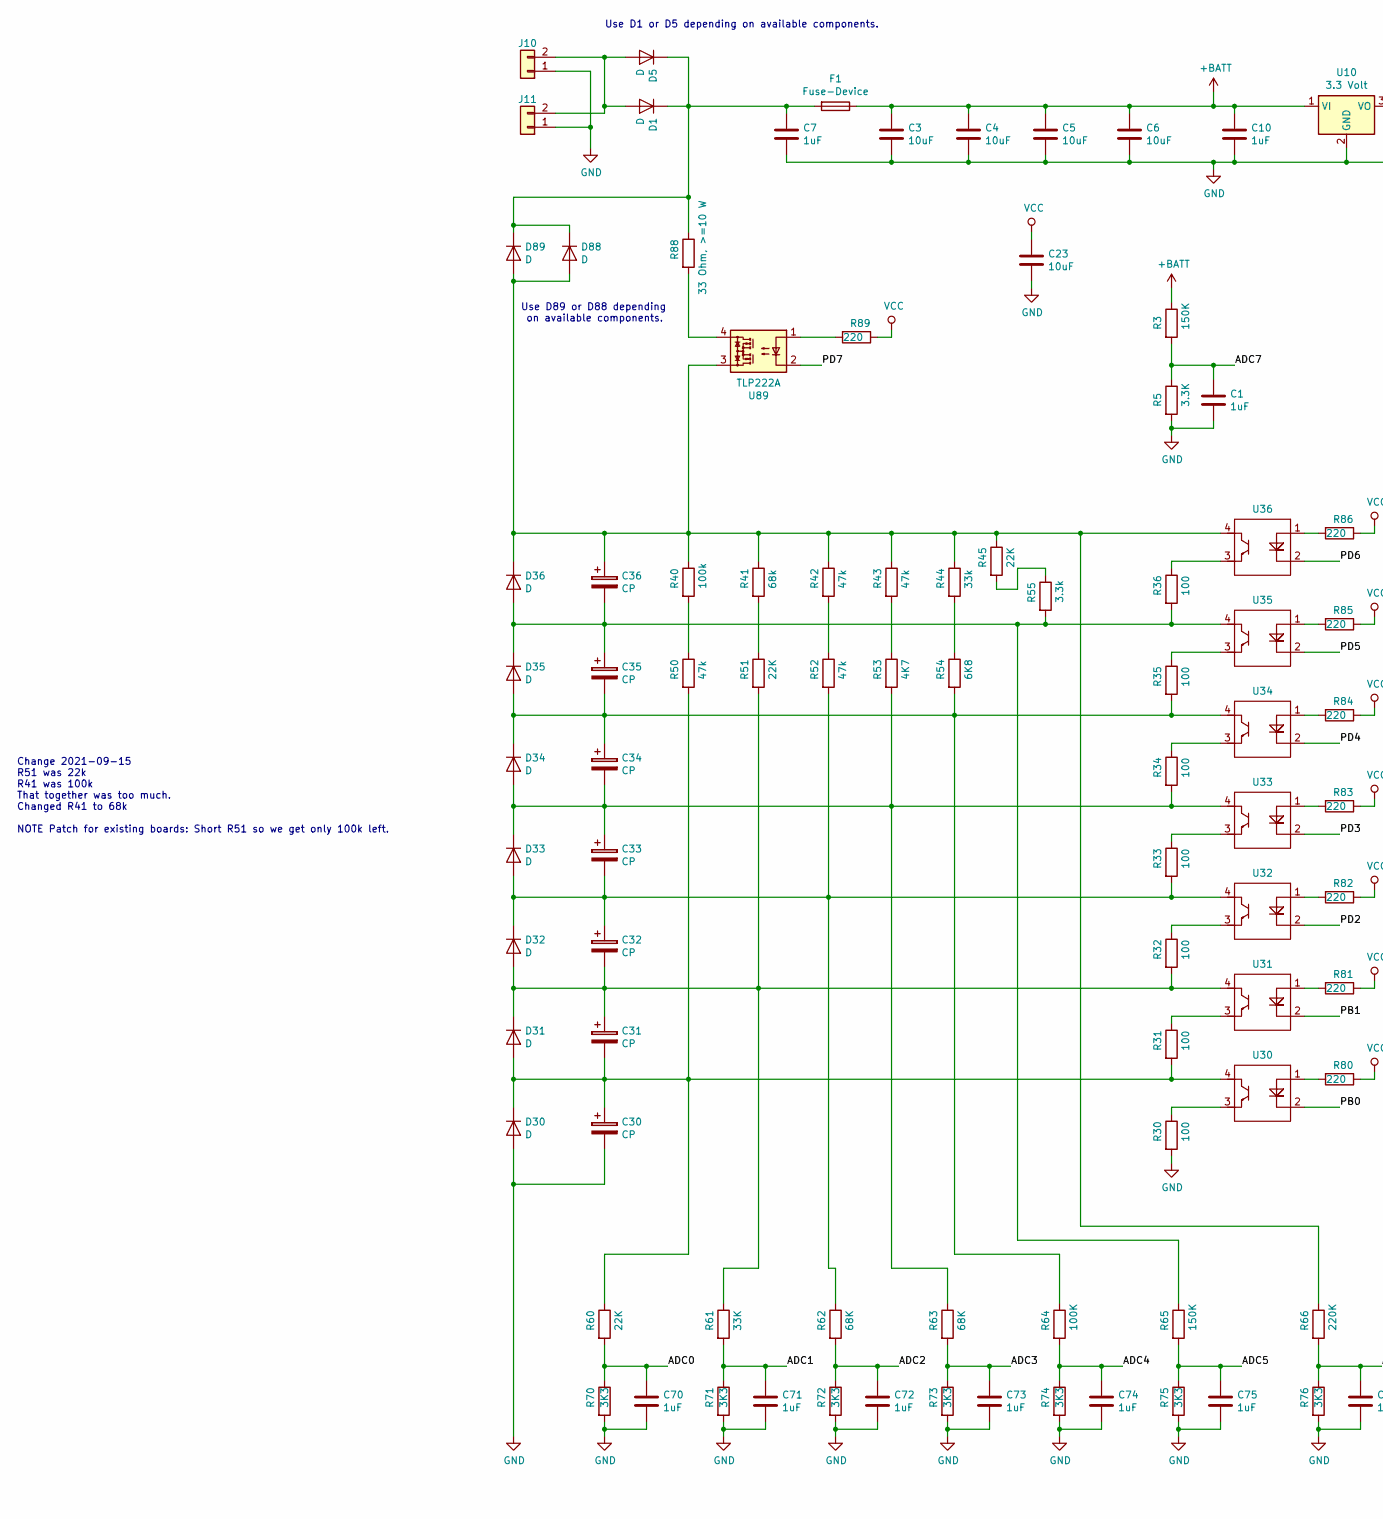
[picture p8: schematic board.sch, SuperCapsUps7 2021, part in row 1, column 1]

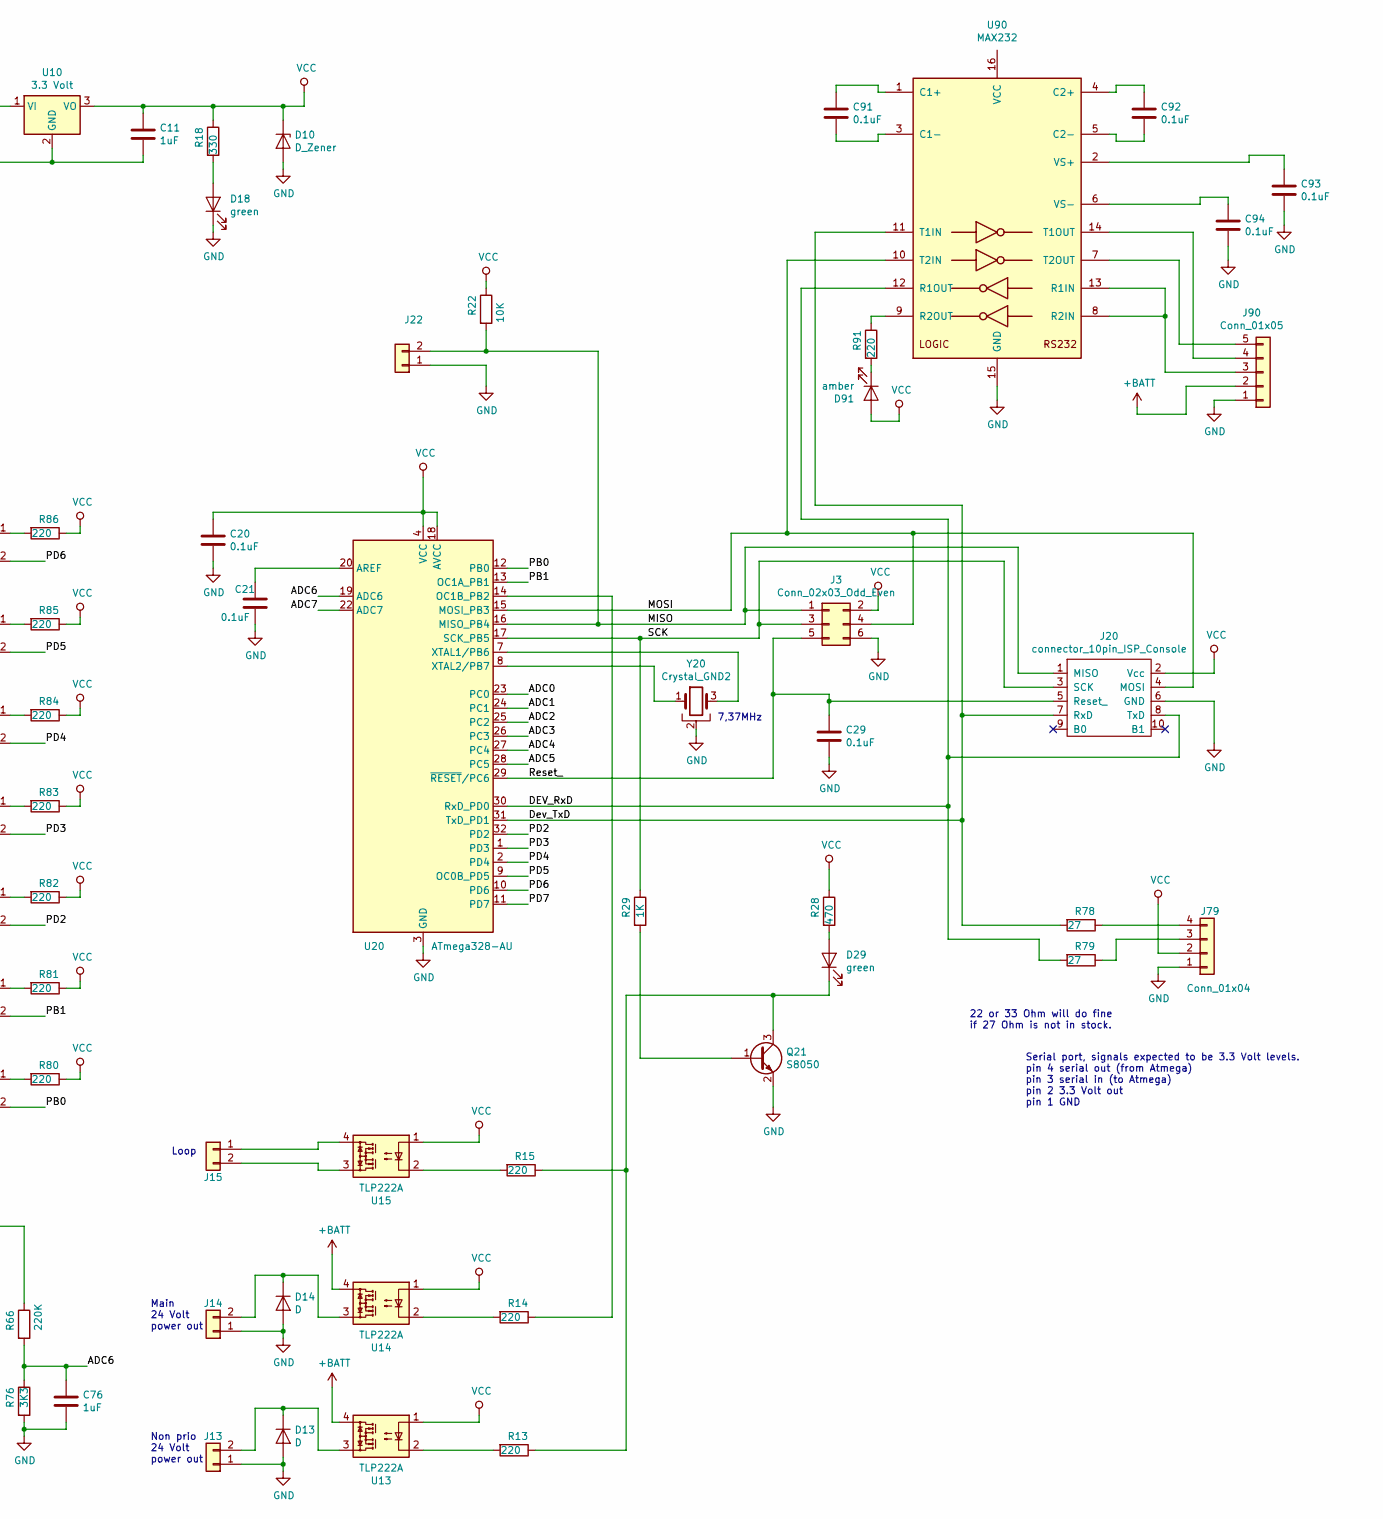
[picture p9: schematic board.sch, SuperCapsUps7 2021, part in row 1, column 2]

Parts:
C1, C7, C10, C11, C70, C71, C72, C73, C74, C75, C76: 1uF; C_0805_2012Metric
C3, C4, C5, C6: 10uF; C_1206_3216Metric
C20, C21, C29, C91, C92, C93, C94: 0.1uF; C_0805_2012Metric
C23: 10uF; C_0805_2012Metric
C30, C31, C32, C33, C34, C35, C36: CP; CP_Radial_D18.0mm_P7.50mm
D1, D89: D; D_SMC
D5, D13, D14, D30, D31, D32, D33, D34, D35, D36, D88: D; D_SMA
D10: D_Zener; D_SMB
D18, D29: green; LED_0805_2012Metric
D91: amber; LED_0805_2012Metric
F1: Fuse-Device; Varistor_RV_Disc_D9mm_W5.7mm_P5mm
J3: Conn_02x03_Odd_Even; PinHeader_2x03_P2.54mm_Vertical
J10, J11, J13, J14, J15: Conn_01x02; connector_TE_Connectivity_2_pin
J20: connector_10pin_ISP_Console; connector_10pin_TC2050-IDC-NL
J22: Conn_01x02; Molex_KK-254_AE-6410-02A_1x02_P2.54mm_Vertical
J79: Conn_01x04; Molex_KK-254_AE-6410-04A_1x04_P2.54mm_Vertical
J90: Conn_01x05; Molex_KK-254_AE-6410-05A_1x05_P2.54mm_Vertical
Q21: S8050; SOT-23
R3, R65: 150K; R_0805_2012Metric
R5: 3.3K; R_0805_2012Metric
R13, R14, R15, R80, R81, R82, R83, R84, R85, R86, R89, R91: 220; R_0805_2012Metric
R18: 330; R_0805_2012Metric
R22: 10K; R_0805_2012Metric
R28: 470; R_0805_2012Metric
R29: 1K; R_0805_2012Metric
R30, R31, R32, R33, R34, R35, R36: 100; R_1206_3216Metric
R40: 100k; R_0805_2012Metric
R41: 68k; R_0805_2012Metric
R42, R43, R50, R52: 47k; R_0805_2012Metric
R44: 33k; R_0805_2012Metric
R45, R51, R60: 22K; R_0805_2012Metric
R53: 4K7; R_0805_2012Metric
R54: 6K8; R_0805_2012Metric
R55: 3.3k; R_0805_2012Metric
R61: 33K; R_0805_2012Metric
R62, R63: 68K; R_0805_2012Metric
R64: 100K; R_0805_2012Metric
R66: 220K; R_0805_2012Metric
R70, R71, R72, R73, R74, R75, R76: 3K3; R_0805_2012Metric
R78, R79: 27; R_0805_2012Metric
R88: 33 Ohm, >=10 W; TO-220-2_with_heatsink_V8508B
U10: 3.3 Volt; DC-DC-Recom-R78
U13, U14, U15, U89: TLP222A; DIP-4_W7.62mm
U20: ATmega328-AU; TQFP-32_7x7mm_P0.8mm
U30, U31, U32, U33, U34, U35, U36: opto_coupler_EL357N(B)(TA)-G; SOP-4_4.1x4.4x2.54P
U90: MAX232; SOIC-16_3.9x9.9mm_P1.27mm
Y20: Crystal_GND2; Resonator-3Pin_W7.0mm_H2.5mm

Connections:
+BATT: C3.1, C4.1, C5.1, C6.1, C10.1, F1.1, J90.2, R3.1, U10.1 (VI), U13.4, U14.4
/ADC0: C70.1, R60.2, R70.1, U20.23 (PC0)
/ADC1: C71.1, R61.2, R71.1, U20.24 (PC1)
/ADC2: C72.1, R62.2, R72.1, U20.25 (PC2)
/ADC3: C73.1, R63.2, R73.1, U20.26 (PC3)
/ADC4: C74.1, R64.2, R74.1, U20.27 (PC4)
/ADC5: C75.1, R65.2, R75.1, U20.28 (PC5)
/ADC6: C76.1, R66.2, R76.1, U20.19 (ADC6)
/ADC7: C1.1, R3.2, R5.1, U20.22 (ADC7)
/DEV_RxD: J20.8 (TxD), R79.2, U20.30 (RxD_PD0), U90.12 (R1OUT)
/Dev_TxD: J20.7 (RxD), R78.2, U20.31 (TxD_PD1), U90.11 (T1IN)
/MISO: J3.1, J20.1 (MISO), J22.2, R22.2, U20.16 (MISO_PB4)
/MOSI: J3.4, J20.4 (MOSI), U20.15 (MOSI_PB3), U90.10 (T2IN)
/PB0: U20.12 (PB0), U30.2
/PB1: U20.13 (OC1A_PB1), U31.2
/PD2: U20.32 (PD2), U32.2
/PD3: U20.1 (PD3), U33.2
/PD4: U20.2 (PD4), U34.2
/PD5: U20.9 (OC0B_PD5), U35.2
/PD6: U20.10 (PD6), U36.2
/PD7: U20.11 (PD7), U89.2
/Reset_: C29.1, J3.5, J20.5 (Reset_), U20.29 (~RESET~/PC6)
/SCK: J3.3, J20.3 (SCK), R29.1, U20.17 (SCK_PB5)
GND: C1.2, C3.2, C4.2, C5.2, C6.2, C7.2, C10.2, C11.2, C20.2, C21.2, C23.2, C29.2, C30.2, C70.2, C71.2, C72.2, C73.2, C74.2, C75.2, C76.2, C93.2, C94.2, D10.2 (A), D13.2 (A), D14.2 (A), D18.1 (K), D30.2 (A), J3.6, J10.1, J11.1, J13.1, J14.1, J20.6 (GND), J22.1, J79.1, J90.1, Q21.2 (E), R5.2, R30.2, R70.2, R71.2, R72.2, R73.2, R74.2, R75.2, R76.2, U10.2 (GND), U20.3 (GND), U20.5 (GND), U20.21 (GND), U90.15 (GND), Y20.2
unnamed: C7.1, D1.1 (K), D5.1 (K), D88.1 (K), D89.1 (K), F1.2, R88.1
unnamed: C21.1, U20.20 (AREF)
unnamed: C30.1, C31.2, D30.1 (K), D31.2 (A), R31.2, R50.2, R60.1, U30.4
unnamed: C31.1, C32.2, D31.1 (K), D32.2 (A), R32.2, R51.2, R61.1, U31.4
unnamed: C32.1, C33.2, D32.1 (K), D33.2 (A), R33.2, R52.2, R62.1, U32.4
unnamed: C33.1, C34.2, D33.1 (K), D34.2 (A), R34.2, R53.2, R63.1, U33.4
unnamed: C34.1, C35.2, D34.1 (K), D35.2 (A), R35.2, R54.2, R64.1, U34.4
unnamed: C35.1, C36.2, D35.1 (K), D36.2 (A), R36.2, R55.2, R65.1, U35.4
unnamed: C36.1, D36.1 (K), D88.2 (A), D89.2 (A), R40.1, R41.1, R42.1, R43.1, R44.1, R45.1, R66.1, U36.4, U89.3
unnamed: C91.1, U90.1 (C1+)
unnamed: C91.2, U90.3 (C1-)
unnamed: C92.1, U90.4 (C2+)
unnamed: C92.2, U90.5 (C2-)
unnamed: C93.1, U90.2 (VS+)
unnamed: C94.1, U90.6 (VS-)
unnamed: D1.2 (A), D5.2 (A), J10.2, J11.2
unnamed: D13.1 (K), J13.2, U13.3
unnamed: D14.1 (K), J14.2, U14.3
unnamed: D18.2 (A), R18.2
unnamed: D29.1 (K), Q21.3 (C), R13.1, R15.1
unnamed: D29.2 (A), R28.2
unnamed: D91.1 (K), R91.2
unnamed: J15.1, U15.4
unnamed: J15.2, U15.3
unnamed: J79.3, R79.1
unnamed: J79.4, R78.1
unnamed: J90.3, U90.8 (R2IN), U90.13 (R1IN)
unnamed: J90.4, U90.14 (T1OUT)
unnamed: J90.5, U90.7 (T2OUT)
unnamed: Q21.1 (B), R29.2
unnamed: R13.2, U13.2
unnamed: R14.1, U20.14 (OC1B_PB2)
unnamed: R14.2, U14.2
unnamed: R15.2, U15.2
unnamed: R30.1, U30.3
unnamed: R31.1, U31.3
unnamed: R32.1, U32.3
unnamed: R33.1, U33.3
unnamed: R34.1, U34.3
unnamed: R35.1, U35.3
unnamed: R36.1, U36.3
unnamed: R40.2, R50.1
unnamed: R41.2, R51.1
unnamed: R42.2, R52.1
unnamed: R43.2, R53.1
unnamed: R44.2, R54.1
unnamed: R45.2, R55.1
unnamed: R80.2, U30.1
unnamed: R81.2, U31.1
unnamed: R82.2, U32.1
unnamed: R83.2, U33.1
unnamed: R84.2, U34.1
unnamed: R85.2, U35.1
unnamed: R86.2, U36.1
unnamed: R88.2, U89.4
unnamed: R89.2, U89.1
unnamed: R91.1, U90.9 (R2OUT)
unnamed: U20.7 (XTAL1/PB6), Y20.3
unnamed: U20.8 (XTAL2/PB7), Y20.1
VCC: C11.1, C20.1, C23.1, D10.1 (K), D91.2 (A), J3.2, J20.2 (Vcc), J79.2, R18.1, R22.1, R28.1, R80.1, R81.1, R82.1, R83.1, R84.1, R85.1, R86.1, R89.1, U10.3 (VO), U13.1, U14.1, U15.1, U20.4 (VCC), U20.6 (VCC), U20.18 (AVCC)

Notes on the sheet:
7,37MHz
Serial port, signals expected to be 3.3 Volt levels. pin 4 serial out (from Atmega) pin 3 serial in (to Atmega) pin 2 3.3 Volt out pin 1 GND
22 or 33 Ohm will do fine if 27 Ohm is not in stock.
Main 24 Volt power out
Non prio 24 Volt power out
Use D1 or D5 depending on available components.
Use D89 or D88 depending on available components.
Loop
Change 2021-09-15 R51 was 22k R41 was 100k That together was too much. Changed R41 to 68k NOTE Patch for existing boards: Short R51 so we get only 100k left.

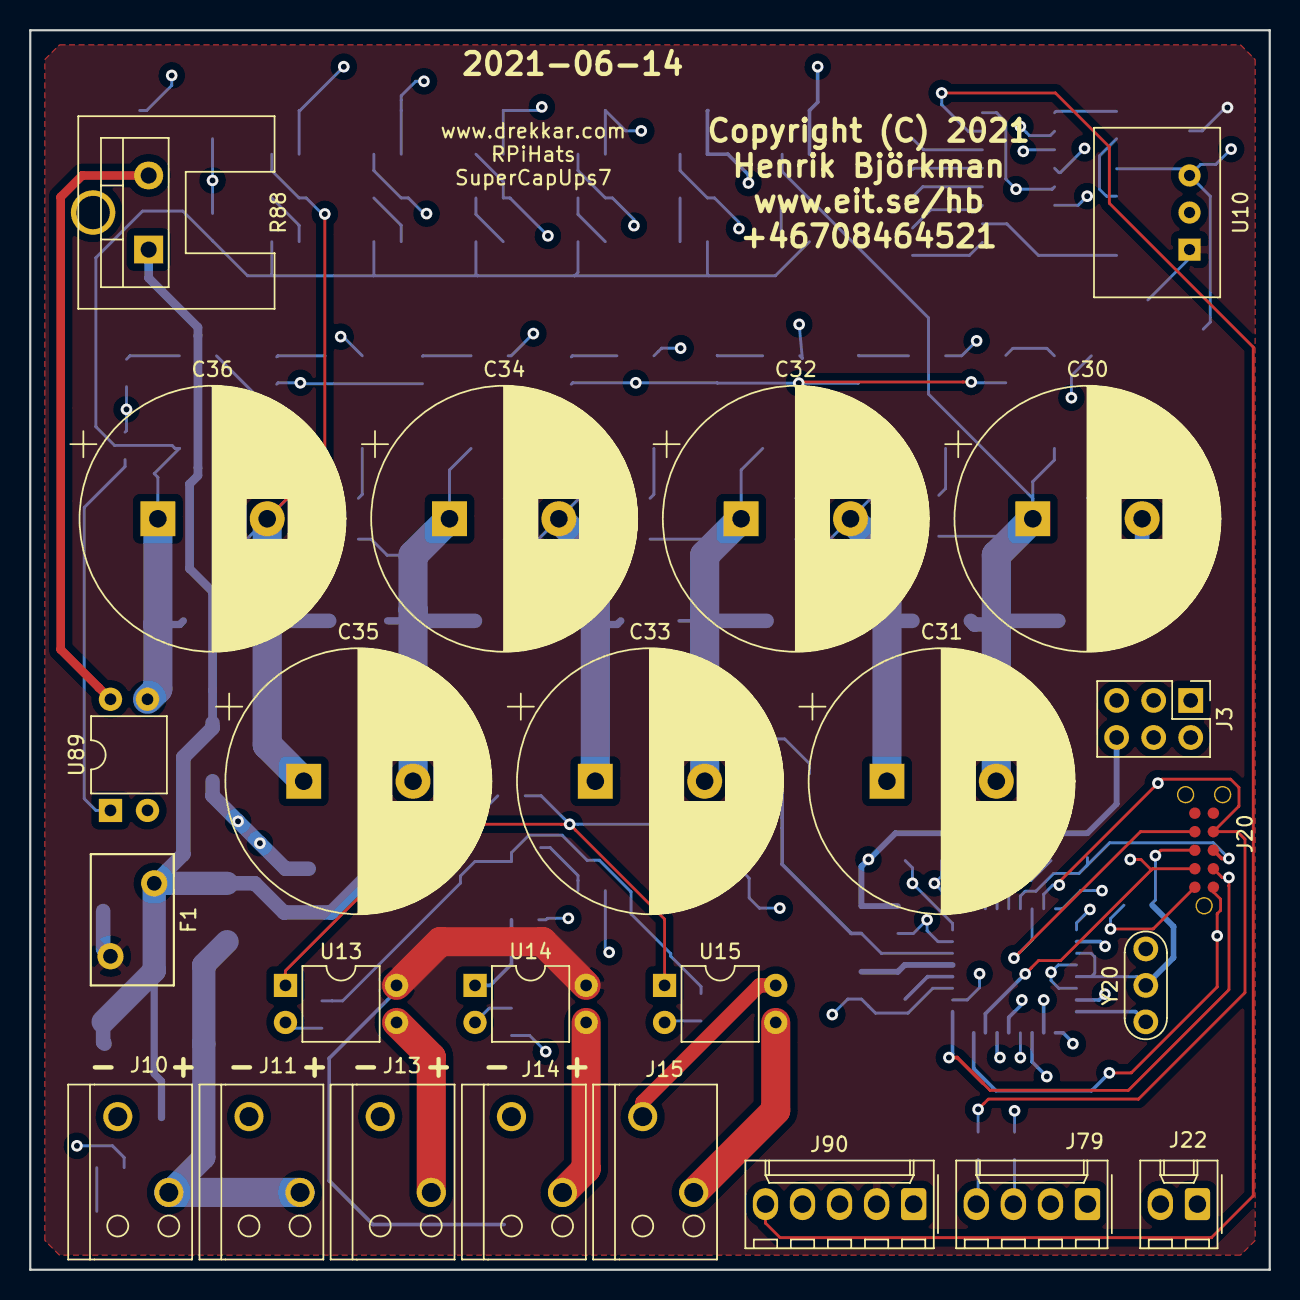
[picture p10: board SuperCapUps7_rs232/board.kicad_pcb from above]

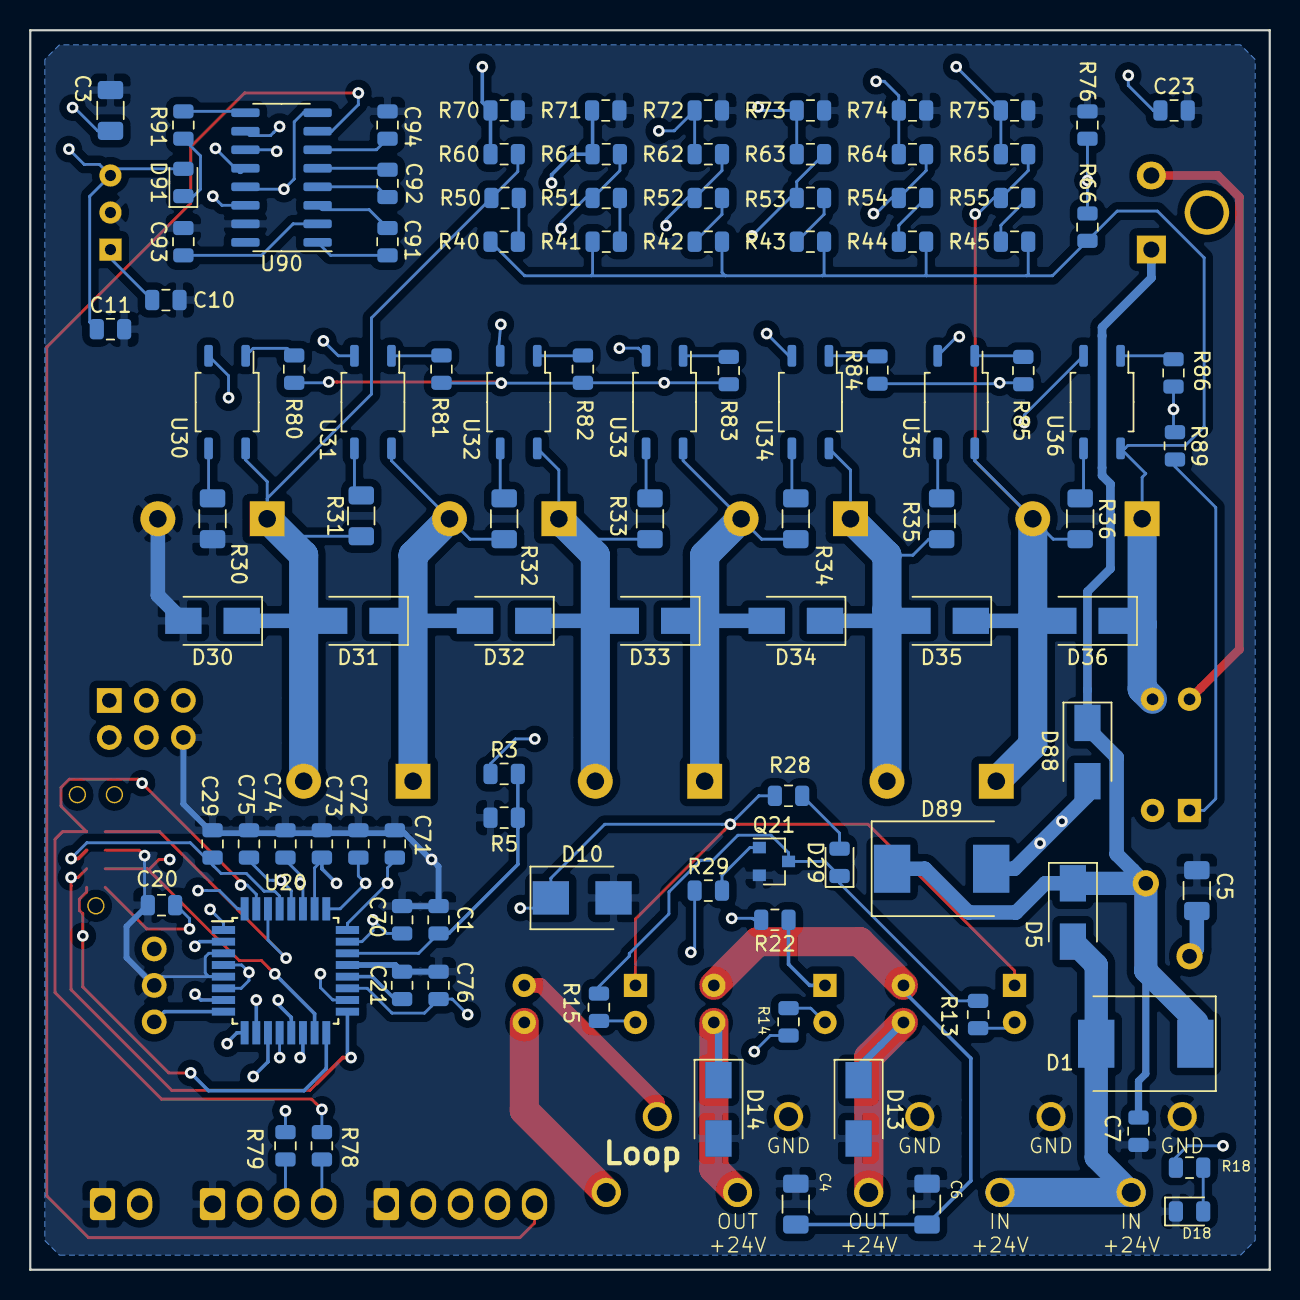
[picture p11: board SuperCapUps7_rs232/board.kicad_pcb from below]

Board: 4 copper layers, 85.0 x 85.0 mm, 128 parts (103 on the bottom side), 84 nets.
