xehp/Power_for_Raspberry_PI/habl/kicad/programmer_board/board.kicad_pcb

## KiCad design habl/kicad/programmer_board/board.kicad_pcb (2021-09-27)

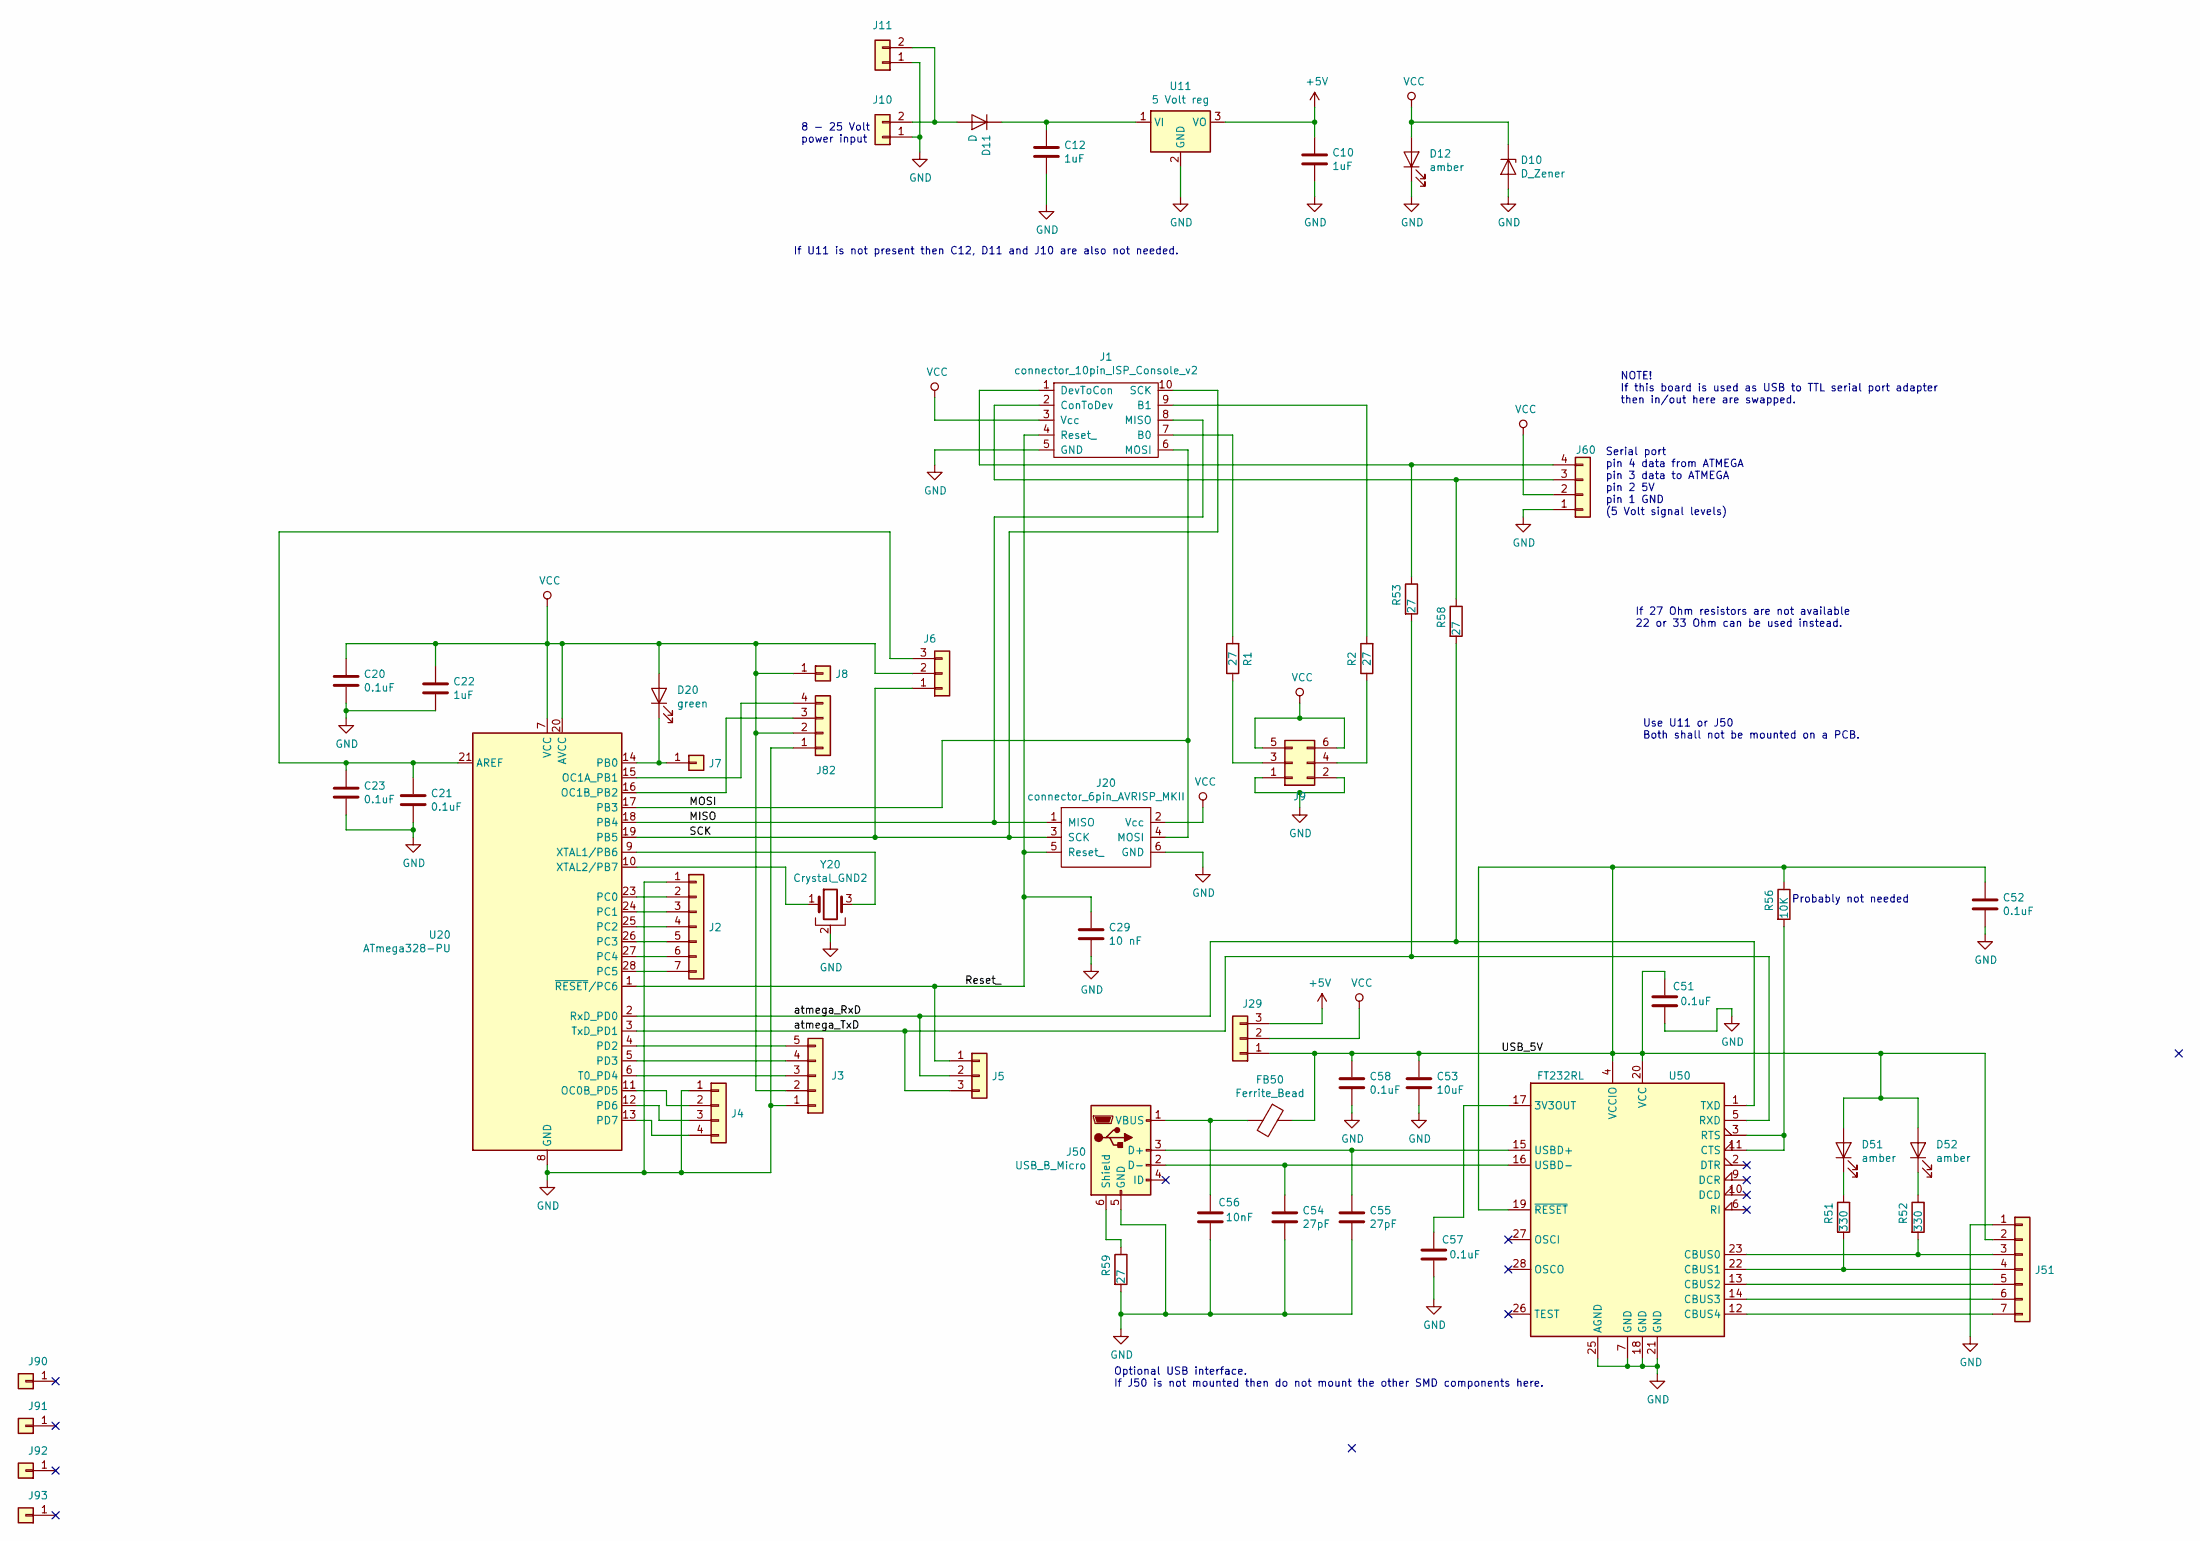
[picture p12: schematic board.sch, programmer board 2021]

Parts:
C10, C12: 1uF; C_Disc_D5.0mm_W2.5mm_P2.50mm
C20, C21: 0.1uF; C_Disc_D5.0mm_W2.5mm_P2.50mm
C22: 1uF; C_0805_2012Metric_Pad1.15x1.40mm_HandSolder
C23, C51, C52, C57, C58: 0.1uF; C_0805_2012Metric_Pad1.15x1.40mm_HandSolder
C29: 10 nF; C_0805_2012Metric
C53: 10uF; C_1206_3216Metric
C54, C55: 27pF; C_0805_2012Metric_Pad1.15x1.40mm_HandSolder
C56: 10nF; C_0805_2012Metric_Pad1.15x1.40mm_HandSolder
D10: D_Zener; D_A-405_P2.54mm_Vertical_AnodeUp
D11: D; D_A-405_P2.54mm_Vertical_AnodeUp
D12: amber; LED_D3.0mm
D20: green; LED_D3.0mm
D51, D52: amber; LED_0805_2012Metric
FB50: Ferrite_Bead; SMD-4.2x4.4x2.0_inductor
J1: connector_10pin_ISP_Console_v2; PinSocket_2x05_P2.54mm_Vertical
J2, J51: Conn_01x07; PinHeader_1x07_P2.54mm_Vertical
J3: Conn_01x05; PinHeader_1x05_P2.54mm_Vertical
J4: Conn_01x04-Connector_Generic; PinHeader_1x04_P2.54mm_Vertical
J5, J6: Conn_01x03-Connector_Generic; PinHeader_1x03_P2.54mm_Vertical
J7, J8: Conn_01x01; PinHeader_1x01_P2.54mm_Vertical
J9: Conn_02x03_Odd_Even; PinHeader_2x03_P2.54mm_Vertical
J10: Conn_01x02; connector_TE_Connectivity_2_pin
J11: Conn_01x02; Molex_KK-254_AE-6410-02A_1x02_P2.54mm_Vertical
J20: connector_6pin_AVRISP_MKII; PinHeader_2x03_P2.54mm_Vertical
J29: Conn_01x03; PinHeader_1x03_P2.54mm_Vertical
J50: USB_B_Micro; USB_Micro_B_Female_jlcpcb
J60: Conn_01x04; Molex_KK-254_AE-6410-04A_1x04_P2.54mm_Vertical
J82: Conn_01x04; PinHeader_1x04_P2.54mm_Vertical
J90, J91, J92, J93: Conn_01x01; MountingHole_3mm_Pad
R1, R2, R59: 27; R_0805_2012Metric_Pad1.15x1.40mm_HandSolder
R51, R52: 330; R_0805_2012Metric_Pad1.15x1.40mm_HandSolder
R53, R58: 27; R_0805_2012Metric
R56: 10K; R_0805_2012Metric_Pad1.15x1.40mm_HandSolder
U11: 5 Volt reg; TO-220-3_with_heatsink_V8508B
U20: ATmega328-PU; socket_28pin_zif
U50: FT232RL; SSOP-28_5.3x10.2mm_P0.65mm
Y20: Crystal_GND2; Resonator-3Pin_W7.0mm_H2.5mm

Connections:
+5V: C10.1, J29.3, U11.3 (VO)
/MISO: J1.8 (MISO), J20.1 (MISO), U20.18 (PB4)
/MOSI: J1.6 (MOSI), J20.4 (MOSI), U20.17 (PB3)
/Reset_: C29.1, J1.4 (Reset_), J5.1, J20.5 (Reset_), U20.1 (~RESET~/PC6)
/SCK: J1.10 (SCK), J6.1, J20.3 (SCK), U20.19 (PB5)
/USB_5V: C51.1, C52.1, C53.1, C58.1, D51.2 (A), D52.2 (A), FB50.1, J29.1, J51.2, R56.1, U50.4 (VCCIO), U50.19 (~RESET~), U50.20 (VCC)
/atmega_RxD: J5.2, R58.2, U20.2 (RxD_PD0), U50.1 (TXD)
/atmega_TxD: J5.3, R53.2, U20.3 (TxD_PD1), U50.5 (RXD)
GND: C10.2, C12.2, C20.2, C21.2, C22.2, C23.2, C29.2, C51.2, C52.2, C53.2, C54.2, C55.2, C56.2, C57.2, C58.2, D10.2 (A), D12.1 (K), J1.5 (GND), J2.1, J3.1, J4.1, J9.1, J9.2, J10.1, J11.1, J20.6 (GND), J50.5 (GND), J51.1, J60.1, J82.1, R59.2, U11.2 (GND), U20.8 (GND), U20.22 (GND), U50.7 (GND), U50.18 (GND), U50.21 (GND), U50.25 (AGND), Y20.2
unnamed: C12.1, D11.1 (K), U11.1 (VI)
unnamed: C21.1, C23.1, J6.3, U20.21 (AREF)
unnamed: C54.1, J50.2 (D-), U50.16 (USBD-)
unnamed: C55.1, J50.3 (D+), U50.15 (USBD+)
unnamed: C56.1, FB50.2, J50.1 (VBUS)
unnamed: C57.1, U50.17 (3V3OUT)
unnamed: D11.2 (A), J10.2, J11.2
unnamed: D20.1 (K), J7.1, U20.14 (PB0)
unnamed: D51.1 (K), R51.1
unnamed: D52.1 (K), R52.1
unnamed: J1.1 (DevToCon), J60.4, R53.1
unnamed: J1.2 (ConToDev), J60.3, R58.1
unnamed: J1.7 (B0), R1.2
unnamed: J1.9 (B1), R2.2
unnamed: J2.2, U20.23 (PC0)
unnamed: J2.3, U20.24 (PC1)
unnamed: J2.4, U20.25 (PC2)
unnamed: J2.5, U20.26 (PC3)
unnamed: J2.6, U20.27 (PC4)
unnamed: J2.7, U20.28 (PC5)
unnamed: J3.3, U20.6 (T0_PD4)
unnamed: J3.4, U20.5 (PD3)
unnamed: J3.5, U20.4 (PD2)
unnamed: J4.2, U20.11 (OC0B_PD5)
unnamed: J4.3, U20.12 (PD6)
unnamed: J4.4, U20.13 (PD7)
unnamed: J9.3, R1.1
unnamed: J9.4, R2.1
unnamed: J50.6 (Shield), R59.1
unnamed: J51.3, R52.2, U50.23 (CBUS0)
unnamed: J51.4, R51.2, U50.22 (CBUS1)
unnamed: J51.5, U50.13 (CBUS2)
unnamed: J51.6, U50.14 (CBUS3)
unnamed: J51.7, U50.12 (CBUS4)
unnamed: J82.3, U20.16 (OC1B_PB2)
unnamed: J82.4, U20.15 (OC1A_PB1)
unnamed: R56.2, U50.3 (RTS), U50.11 (CTS)
unnamed: U20.9 (XTAL1/PB6), Y20.3
unnamed: U20.10 (XTAL2/PB7), Y20.1
VCC: C20.1, C22.1, D10.1 (K), D12.2 (A), D20.2 (A), J1.3 (Vcc), J3.2, J6.2, J8.1, J9.5, J9.6, J20.2 (Vcc), J29.2, J60.2, J82.2, U20.7 (VCC), U20.20 (AVCC)

Notes on the sheet:
Serial port pin 4 data from ATMEGA pin 3 data to ATMEGA pin 2 5V pin 1 GND (5 Volt signal levels)
Use U11 or J50 Both shall not be mounted on a PCB.
8 - 25 Volt power input
If 27 Ohm resistors are not available 22 or 33 Ohm can be used instead.
NOTE! If this board is used as USB to TTL serial port adapter then in/out here are swapped.
If U11 is not present then C12, D11 and J10 are also not needed.
Optional USB interface. If J50 is not mounted then do not mount the other SMD components here.
Probably not needed

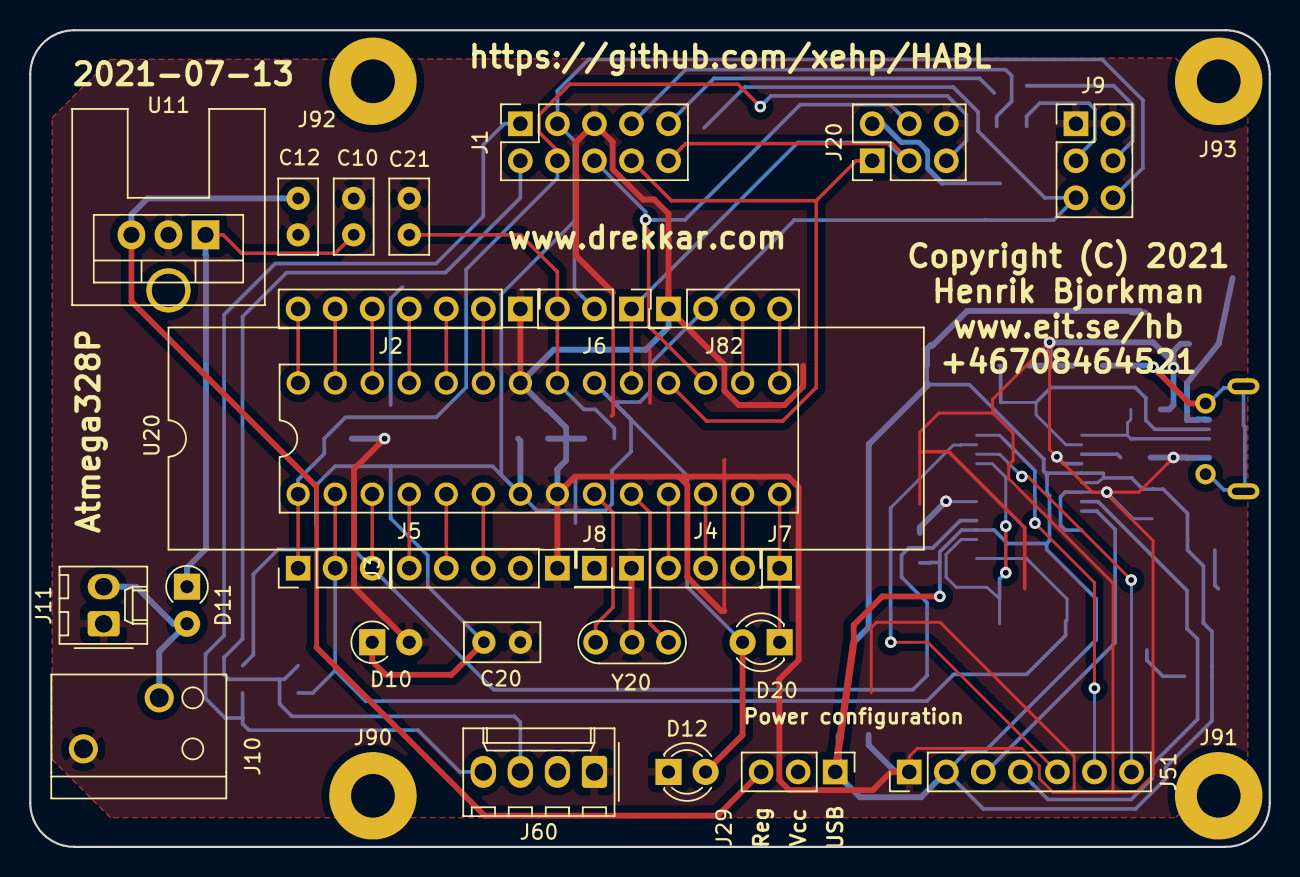
[picture p13: board habl/kicad/programmer_board/board.kicad_pcb from above]

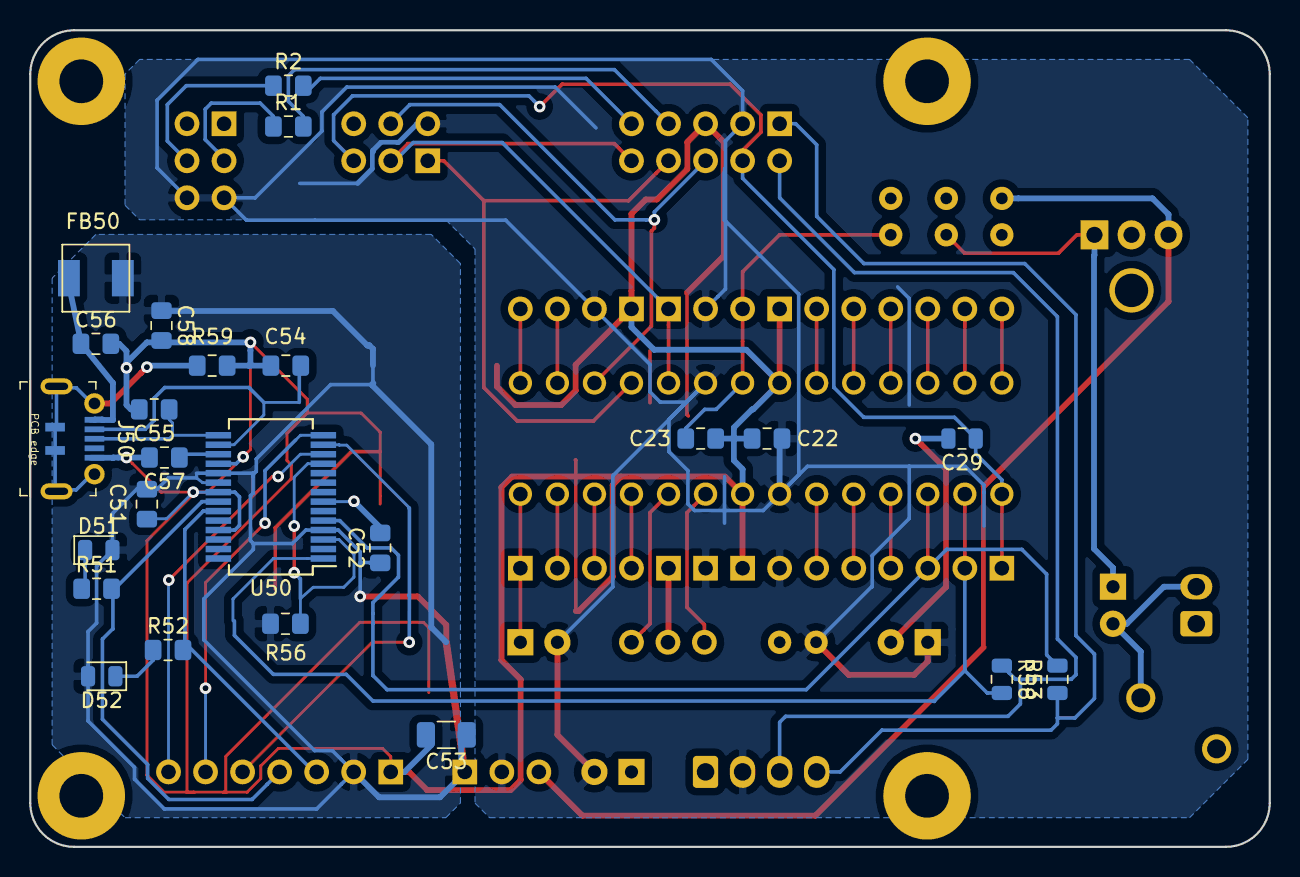
[picture p14: board habl/kicad/programmer_board/board.kicad_pcb from below]

Board: 4 copper layers, 85.0 x 56.0 mm, 55 parts (24 on the bottom side), 49 nets.
