xehp/Power_for_Raspberry_PI/software/examples/configuration_rtc_and_display.txt

Error: Could not open file `/dev/i2c-1' or `/dev/i2c/1' : No such file or directory.
https://www.raspberrypi.org/forums/viewtopic.php?t=115080
