xehp/Power_for_Raspberry_PI/(commit log)

2021-09-27 copied files over from the RPi_HATs repository
    [board.kicad_pcb, board.sch, board_bom_for_jlcpcb.csv, bom.xls, downloaded_bom.xls, raspberrrypi_hat-2020-08-09-19-13-19.sch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]
2021-10-06 This version was tested and something failed, see SuperCapUps7_rs232/bom.txt for details
    [board.sch, configuration_rtc_and_display.txt, raspberrrypi_hat.kicad_pcb, raspberrrypi_hat.sch]
