xehp/Power_for_Raspberry_PI/(notices)

Notices in the files:
software/ups7_sw/cmd.c:
under the terms of the GNU Lesser General Public License version 2.1.
